jie326513988/ESP32C3-JDI-LCD-LVGL/Introducing pictures/1 (2).png

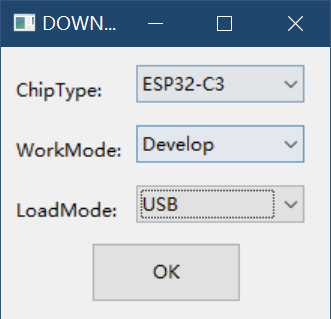
Introducing pictures/1 (2).png
