jie326513988/ESP32C3-JDI-LCD-LVGL/src/my_LVGLDemo.h

void demo_label()
{
  /*更改活动屏幕的背景色*/
  // lv_obj_set_style_bg_color(lv_screen_active(), lv_color_make(255, 0, 255), LV_PART_MAIN);

  /*Create a white label, set its text and align it to the center*/
  // lv_obj_t * label = lv_label_create(lv_screen_active());
  // lv_label_set_text(label, "Hello world");
  // lv_obj_set_style_text_color(lv_screen_active(), lv_color_hex(0xffffff), LV_PART_MAIN);
  // lv_obj_align(label, LV_ALIGN_CENTER, 0, 0);

  /*lv_obj_t *ta1 = lv_textarea_create(lv_scr_act());
  lv_obj_set_size(ta1, 70, 30);
  lv_obj_align(ta1, LV_ALIGN_CENTER, 0, -25);
  lv_obj_set_style_bg_color(ta1, lv_color_make(255, 0, 0), LV_STATE_DEFAULT);*/

  // 设置文本框的大小和位置
  /*
  lv_obj_t *ta1 = lv_textarea_create(lv_scr_act());
  lv_obj_set_size(ta1, 70, 30);
  lv_obj_align(ta1, LV_ALIGN_CENTER, 0, 30);
  lv_obj_set_style_bg_color(ta1, lv_color_make(255, 0, 0), LV_STATE_DEFAULT); // rgb
  */

  // 基本对象
  lv_obj_t *obj1 = lv_obj_create(lv_screen_active());
  lv_obj_set_scrollbar_mode(obj1, LV_SCROLLBAR_MODE_OFF);
  lv_obj_align(obj1, LV_ALIGN_TOP_MID, 0, 5);
  lv_obj_set_size(obj1, 72, 30);
  lv_obj_set_style_bg_color(obj1, MY_COLOR_GREEN, LV_STATE_DEFAULT);
  // 设置标签
  lv_obj_t *label = lv_label_create(obj1);
  lv_obj_set_scrollbar_mode(label, LV_SCROLLBAR_MODE_OFF);
  lv_label_set_long_mode(label, LV_LABEL_LONG_SCROLL_CIRCULAR);
  lv_obj_align(label, LV_ALIGN_CENTER, 0, 0);
  lv_obj_set_width(label, 72);
  //lv_label_set_text(label, "Hello Arduino, I'm LVGL! -V9.1.0");
}

void demo_img()
{
  // 1.准备一张图片
  LV_IMG_DECLARE(maomao);
  // 2.创建一个lv_img对象
  lv_obj_t *img1 = lv_image_create(lv_screen_active());
  // 3.给对象设置图片
  lv_image_set_src(img1, &maomao);
  // 4.设置图片位置
  lv_obj_align(img1, LV_ALIGN_BOTTOM_MID, 0, 0);
}

void demo_gif()
{
  /*
    // 1.准备一张图片
    LV_IMG_DECLARE(qft);
    // 2.创建一个lv_img对象
    lv_obj_t *gif1 = lv_gif_create(lv_screen_active());
    // 3.给对象设置图片
    lv_gif_set_src(gif1, &qft);
    // 4.设置图片位置
    lv_obj_align(gif1, LV_ALIGN_BOTTOM_MID, 0, 0);
  */

  // qft 千反田，tw 跳舞，xiaomai 小埋，yqs 摇汽水，liuhua 六花
  LV_IMG_DECLARE(liuhua);
  lv_obj_t *gif2 = lv_gif_create(lv_screen_active());
  lv_gif_set_src(gif2, &liuhua);
  lv_obj_align(gif2, LV_ALIGN_CENTER, 0, 0);
}

lv_point_precise_t *my_draw_rectangle(uint16_t x, uint16_t y, uint16_t w, uint16_t h)
{
  static lv_point_precise_t line_points[5]; // 静态数组，存储矩形的点
  line_points[0] = (lv_point_precise_t){x, y};
  line_points[1] = (lv_point_precise_t){x + w, y};
  line_points[2] = (lv_point_precise_t){x + w, y + h};
  line_points[3] = (lv_point_precise_t){x, y + h};
  line_points[4] = (lv_point_precise_t){x, y}; // 闭合矩形
  return line_points;
}

// 开机时进入哪个界面
void pageStartupEnters()
{
  // 更新闹钟时间差
  updatealarmClockDifference(1);

  // 0点唤醒的 并且 不是时钟界面
  if (RTC_ac_wp > 0 && RTC_disPage_old != page_clock)
  {
    // 5秒内视为有闹钟
    if (abs(AC_timeTarget) <= 5)
    {
      AC_timeTarget = AC_WAKE_UP; // 标记唤醒时有闹钟
    }
    else esp_sleep(0);
  }

  // 开机长按确认键10秒进入按键校准界面
  int16_t count = 0;
  while (analogRead(KEY_ADC_PIN) <= 100)
  {
    delay(10);
    count++;
    if (count > 100)
    {
      eep_keyADCUp = 5000;
      eep_keyADCUp = 5000;
      break;
    }
  }

  bool anim = 1; // 是否启用动画
  //Serial.printf("eep_keyADCUp:%d\n",eep_keyADCUp);
  //Serial.printf("eep_keyADCDown:%d\n",eep_keyADCDown);
  if (eep_keyADCUp >= 5000 || eep_keyADCDown >= 5000)
  {
    display_keyADC_cali_init();
    buzzer_active();
  }
  else if (eep_disPage == page_clock)
  {
    // 检查闹钟 5秒内视为有闹钟
    if (abs(AC_timeTarget) <= 5)
    {
      RTC_timedWakeUp = 0;
      AC_timeTarget = AC_WAKE_UP; // 标记唤醒时有闹钟
    }

    display_clock_init();

    // 是定时唤醒的标记不需要动画
    if (RTC_timedWakeUp == 1)  
    {
      anim = 0;
      //添加屏幕保护刷屏 单位分钟
      RTC_clock_count++;
      if (RTC_clock_count > 120)
      {
        RTC_clock_count = 0;
        display_screenSaver_init();
        lv_screen_load_anim(page.p[page.index], LV_SCR_LOAD_ANIM_OVER_LEFT, 100, 0, true);
        return;
      }
    }
    // 不是定时唤醒 打开定时读取时间
    else bitWrite(backgroundTask, BGT_CLOCK_READ, 1);
  }
  else if (eep_disPage == page_acc)
  {
    display_acc_init();
    bitWrite(backgroundTask, BGT_ACC_READ, 1); // 标记打开任务
  }
  else if (eep_disPage == page_mainSet)
  {
    display_mainSet_init();
  }
  else if (eep_disPage == page_air)
  {
    display_air_init();
    bitWrite(backgroundTask, BGT_AIR_READ, 1); // 标记打开任务
  }
  else if (eep_disPage == page_alarmClock)
  {
    display_alarmClock_init();
  }
  else if (eep_disPage == page_fileExplorer)
  {
    fileManagerInit(1);
    display_fileExplorer_init();
  }
  else if (eep_disPage == page_memoSet)
  {
    display_memoSet_init();
  }
  else if (eep_disPage == page_memo)
  {
    display_memo_init();
  }
  else//防止错误
  {
    display_jitterSet_init();
  }

  //Serial.printf("eep_disPage:%d\n", eep_disPage);
  if (anim) //需要动画
  {
    lv_screen_load_anim(page.p[page.index], LV_SCR_LOAD_ANIM_FADE_IN, 1000, 0, false);
    onGlobalJitter(1000); // 打开全局抖动
  }
  else // 不需要动画
  {
    lv_screen_load(page.p[page.index]);
  }
}

//********** 在事件内添加动画，动画不会重叠 返回1动画播放中 返回0动画启动
bool addAnimation_event(lv_obj_t *obj1, void (*animFunctions)(lv_obj_t *obj2), lv_anim_exec_xcb_t exec_cb)
{
  lv_anim_t *a = lv_anim_get(obj1, exec_cb); //button_width_shrink_anim_cb
  if (a != NULL) return 1; // 如果动画正在播放，直接返回
  animFunctions(obj1);     // 调用动画函数
  return 0;
}

//****** 自写弹窗 带动画
/*
lv_anim_path_linear 线性动画
lv_anim_path_step 最后一步改变
lv_anim_path_ease_in 开始时很慢
lv_anim_path_ease_out 最后慢
lv_anim_path_ease_in_out 开始和结束都很慢
lv_anim_path_overshoot 超过结束值
lv_anim_path_bounce 从最终值反弹一点（比如撞墙）
*/
// 弹窗动画 对X轴变化
void my_msgbox_anim_x_cb(void *var, int32_t v) 
{
  //lv_obj_set_x((lv_obj_t *)var, v);
  lv_obj_align((lv_obj_t *)var, LV_ALIGN_LEFT_MID, v, 0);
  //Serial.printf("v:%d\n",v);
}
// 弹窗退出动画结束时删除自己
void my_msgbox_exit_anim_end_cd(lv_anim_t *a) 
{
  // lv_obj_delete((lv_obj_t *)a->var);
  lv_obj_delete(mbox.p); // 删除对象
  mbox.p = NULL;         // 对象地址清空
  mbox.keyMode = KEY_MODE_RL;

  if (group_old != NULL)
  {
    lv_indev_set_group(indev, group_old); // 将组邦定到按键 group_my
    lv_obj_t *obj = lv_group_get_focused(group_old);
    group_old = NULL;
    if (obj != NULL)
      lv_obj_set_state(obj, LV_STATE_PRESSED, false); // 设置状态
  }

  // 检查清空标志
  /*if (bitRead(mbox.state, MBOX_STATE_CLEAR) == 1)
  {
    mbox.title.clear();
    mbox.text.clear();
    mbox.time = 0;
    mbox.recordTime = 0;
    mbox.button.clear();
    mbox.event_cb = NULL;
    bitWrite(mbox.state, MBOX_STATE_CLEAR, 0);
  }*/

  // 定时器存在，删除定时器
  if (lvTimer_msgbox)
  {
    lv_timer_delete(lvTimer_msgbox);
    lvTimer_msgbox = NULL;
  }

  bitWrite(mbox.state, MBOX_STATE_EXIT, 0);   // 标记退出完毕
  bitWrite(mbox.state, MBOX_STATE_REMAIN, 0); // 标记停留阶段结束
  bitWrite(mbox.state, MBOX_STATE_TIMER, 0);  // 取消标记定时器运行阶段
  bitWrite(mbox.state, MBOX_STATE_ENTER, 0);  // 标记进入阶段结束
  /*Serial.println("弹窗退出完毕");
  Serial.print("mbox.state:");
  Serial.println(mbox.state, BIN);
  Serial.println();*/
}
// 弹窗退出 设置多少秒后退出的定时器回调
void my_msgbox_setExit_timer_cb(lv_timer_t *e)
{
  bitWrite(mbox.state, MBOX_STATE_EXIT, 1); // 标记退出中
  int16_t x = lv_obj_get_x(mbox.p);
  lv_anim_t b;
  lv_anim_init(&b);                                         // 动画初始化
  lv_anim_set_var(&b, mbox.p);                              // 设置需要动画的对象
  lv_anim_set_values(&b, x, -78);                           // 设置动画的开始值和结束值
  lv_anim_set_duration(&b, MSGBOX_ANIM_TIME);               // 设置动画的持续时间
  lv_anim_set_exec_cb(&b, my_msgbox_anim_x_cb);             // 设置需要变化的值
  lv_anim_set_path_cb(&b, lv_anim_path_ease_in);            // 设置变化特效
  lv_anim_set_completed_cb(&b, my_msgbox_exit_anim_end_cd); // 设置动画完成时的函数调用
  lv_anim_start(&b);                                        // 动画开始
  //Serial.println("弹窗退出动画开始");
}
// 弹窗退出 供用户调用
void my_msgbox_exit(uint32_t delay_ms)
{
  if (mbox.p == NULL)
  {
    //Serial.println("无弹窗返回");
    return;
  }
  if (bitRead(mbox.state, MBOX_STATE_EXIT))
  {
    //Serial.println("弹窗退出中返回");
    return;
  }

  //Serial.println("弹窗退出开始创建");

  if (lvTimer_msgbox)
  {
    lv_timer_pause(lvTimer_msgbox);  // 暂停
    lv_timer_delete(lvTimer_msgbox); // 删除
    lvTimer_msgbox = NULL;
  }

  if (delay_ms < 5) // 小于5ms直接运行
  {
    my_msgbox_setExit_timer_cb(NULL);
    return;
  } 

  bitWrite(mbox.state, MBOX_STATE_TIMER, 1); // 标记定时器运行阶段
  // 创建一个单次定时器
  lvTimer_msgbox = lv_timer_create(my_msgbox_setExit_timer_cb, delay_ms, NULL);
  lv_timer_set_repeat_count(lvTimer_msgbox, 1);
  lv_timer_set_auto_delete(lvTimer_msgbox, false);
}
// 弹窗进入动画结束回调
void my_msgbox_enter_anim_end_cd(lv_anim_t *a)
{
  //Serial.println("弹窗进入动画结束");
  bitWrite(mbox.state, MBOX_STATE_ENTER, 0);  // 标记进入阶段结束
  bitWrite(mbox.state, MBOX_STATE_REMAIN, 1); // 标记进入停留阶段
}
// 强制发送弹窗 供用户调用
void my_msgbox_forceSend(String title_in, String text_in, uint16_t time, String button, lv_event_cb_t event_cb)
{
  bitWrite(mbox.state, MBOX_STATE_FORCE, 1); // 标记强制发送
  my_msgbox_send(title_in, text_in, time, button, event_cb);
}
// 正常发送弹窗 供用户调用
void my_msgbox_send(String title_in, String text_in, uint16_t time, String button, lv_event_cb_t event_cb)
{
  //Serial.println("弹窗发送");
  //Serial.printf("title_in:%s\n", title_in.c_str());
  //Serial.printf("text_in:%s\n", text_in.c_str());
  //Serial.printf("time:%d\n", time);
  bitWrite(mbox.state, MBOX_STATE_SEND, 1); // 标记发送阶段
  if(title_in) mbox.title = title_in;
  if(text_in)  mbox.text = text_in;
  mbox.time = time;
  if(button)   mbox.button = button;
  if(event_cb) mbox.event_cb = event_cb;
}
// 弹窗进入，供my_msgbox_loop调用，用户勿调用
void my_msgbox(String title_in, String text_in, uint16_t time, String button, lv_event_cb_t event_cb) 
{
  //uint8_t index = msgboxInit();
  bitWrite(mbox.state, MBOX_STATE_ENTER, 1); // 标记进入阶段
  bitWrite(mbox.state, MBOX_STATE_SEND, 0); // 标记发送结束

  // 进入前先清空
  mbox.title.clear();
  mbox.text.clear();
  mbox.time = 0;
  mbox.button.clear();
  mbox.event_cb = NULL;

  const char *title = title_in.c_str();
  const char *text = text_in.c_str();
  // 计算按钮的数量
  uint8_t butNum = 0;
  String button_name[3];
  for (uint8_t i = 0; i < button.length(); i++)
  {
    if (button[i] != '\n') button_name[butNum] += button[i];
    else                   butNum++;
    if (butNum >= 3) break;
  }

  // 大框
  mbox.p = lv_obj_create(lv_layer_top());
  lv_obj_set_scrollbar_mode(mbox.p, LV_SCROLLBAR_MODE_OFF); //关闭滑动条
  //uint16_t width_title = lv_text_get_width(title, strlen(title), lv_obj_get_style_text_font(mbox.p, 0), 0);
  //uint16_t width_text = lv_text_get_width(text, strlen(text), lv_obj_get_style_text_font(mbox.p, 0), 0);
  //uint16_t width_title_zl = (width_title / 69);
  //uint16_t width_text_zl = (width_text / 69);
  //Serial.printf("width_text:%d\n", width_text);
  //Serial.printf("width_text_zl:%d\n", width_text_zl);
  //lv_obj_set_size(mbox.p, 78, 48 + ((width_title_zl + width_text_zl) * 20));
  lv_obj_set_size(mbox.p, 78, 144);
  lv_obj_align(mbox.p, LV_ALIGN_LEFT_MID, -78, 0);
  lv_obj_set_style_text_color(mbox.p, MY_COLOR_BLACK, LV_STATE_DEFAULT);   // 字体颜色
  lv_obj_set_style_border_color(mbox.p, MY_COLOR_BLACK, LV_STATE_DEFAULT); // 边框颜色
  lv_obj_set_style_border_width(mbox.p, 2, LV_STATE_DEFAULT);              // 边框宽度
  lv_obj_set_style_pad_all(mbox.p, 0, LV_STATE_DEFAULT);                   // 边距
  lv_obj_set_style_radius(mbox.p, 9, LV_STATE_DEFAULT);                    // 设置圆角
  lv_obj_set_style_bg_opa(mbox.p, LV_OPA_100, LV_STATE_DEFAULT);

  lv_obj_update_layout(mbox.p); // 更新布局
  uint16_t i_w = lv_obj_get_width(mbox.p);
  uint16_t i_h = lv_obj_get_height(mbox.p);
  uint16_t i_r = lv_obj_get_style_radius(mbox.p, LV_STATE_DEFAULT);

  // 内边框
  lv_obj_t *innerBorder = lv_obj_create(mbox.p);
  lv_obj_set_style_bg_opa(innerBorder, LV_OPA_0, LV_STATE_DEFAULT);
  lv_obj_set_style_border_color(innerBorder, MY_COLOR_CYAN, LV_STATE_DEFAULT);
  lv_obj_set_style_border_width(innerBorder, 2, LV_STATE_DEFAULT);
  lv_obj_set_style_pad_all(innerBorder, 0, LV_STATE_DEFAULT);
  lv_obj_set_style_radius(innerBorder, i_r - 2, LV_STATE_DEFAULT);
  lv_obj_set_size(innerBorder, i_w - 4, i_h - 4);
  lv_obj_align(innerBorder, LV_ALIGN_CENTER, 0, 0);

  // 标题
  lv_obj_t *box_title = lv_label_create(mbox.p);
  // lv_obj_set_style_border_width(box_title, 0, LV_STATE_DEFAULT); // 边框宽度
  // lv_obj_set_style_pad_all(box_title, 0, LV_STATE_DEFAULT);      // 边距
  lv_obj_set_width(box_title, 66);                                                // 设置宽度
  lv_obj_align(box_title, LV_ALIGN_TOP_MID, 1, 2);                                // 设置对齐方式
  lv_obj_set_style_text_color(box_title, MY_COLOR_WHITE, LV_STATE_DEFAULT);       // 设置文本颜色
  lv_label_set_long_mode(box_title, LV_LABEL_LONG_WRAP);                          // 设置文本长字符模式
  lv_obj_set_style_text_align(box_title, LV_TEXT_ALIGN_CENTER, LV_STATE_DEFAULT); // 设置文本对齐方式
  lv_label_set_text(box_title, title);                                            // 打印文本
  
  // 标题的背景
  lv_obj_t *title_bg = lv_obj_create(mbox.p);
  lv_obj_set_style_border_width(title_bg, 0, LV_STATE_DEFAULT);
  lv_obj_set_style_bg_color(title_bg, MY_COLOR_BLACK, LV_STATE_DEFAULT);
  lv_obj_set_style_pad_all(title_bg, 0, LV_STATE_DEFAULT); // 边距
  lv_obj_set_style_radius(title_bg, 0, LV_STATE_DEFAULT);  // 设置圆角
  lv_obj_update_layout(mbox.p);// 更新布局
  lv_obj_set_size(title_bg, i_w - 8, lv_obj_get_height(box_title));
  lv_obj_align(title_bg, LV_ALIGN_TOP_MID, 0, 2);
  lv_obj_swap(title_bg, box_title); // 交换层级

  // 内容
  lv_obj_t *box_text = lv_label_create(mbox.p);
  lv_obj_set_width(box_text, 66);                                                // 设置宽度
  lv_obj_align_to(box_text, box_title, LV_ALIGN_OUT_BOTTOM_MID, 0, 1);           // 设置对齐方式
  lv_label_set_long_mode(box_text, LV_LABEL_LONG_WRAP);                          // 设置文本长字符模式
  lv_obj_set_style_text_align(box_text, LV_TEXT_ALIGN_CENTER, LV_STATE_DEFAULT); // 设置文本对齐方式
  lv_label_set_text(box_text, text);                                             // 打印文本

  // 更新大框的尺寸
  uint8_t additional = 14; //额外高度
  if (butNum == 0) additional = 8; //没有按钮时只需要8
  lv_obj_update_layout(mbox.p); // 更新布局
  i_h = lv_obj_get_height(box_title) + lv_obj_get_height(box_text) + additional + (butNum * 23);
  lv_obj_set_size(mbox.p, 78, i_h);
  lv_obj_align(mbox.p, LV_ALIGN_LEFT_MID, -7, 0);
  // 更新内框的尺寸
  lv_obj_set_size(innerBorder, i_w - 4, i_h - 4);
  lv_obj_align(innerBorder, LV_ALIGN_CENTER, 0, 0);
  lv_obj_move_to_index(innerBorder, lv_obj_get_index(mbox.p) - 2); // 移动到顶层-1

  // Serial.printf("box_title_higth:%d\n", lv_obj_get_height(box_title));
  // Serial.printf("box_text_higth:%d\n", lv_obj_get_height(box_text));
  // Serial.printf("i_h:%d\n", i_h);

  // 按钮存在
  if (butNum != 0)
  {
    // 记录现在的组，以便在退出时恢复
    group_old = lv_indev_get_group(indev);
    // 启用弹窗组
    lv_indev_set_group(indev, group_mbox0);
    // 使能 lv_layer_top 点击
    // lv_obj_add_flag(lv_layer_top(), LV_OBJ_FLAG_CLICKABLE);
    // lv_obj_add_flag(lv_layer_top(), LV_OBJ_FLAG_SCROLL_WITH_ARROW);
    mbox.keyMode = KEY_MODE_PN; // 切换至焦点模式

    // 设置文本的背景
    lv_obj_t *text_bg = lv_obj_create(mbox.p);
    lv_obj_set_style_bg_color(text_bg, MY_COLOR_YELLOW, LV_STATE_DEFAULT);
    lv_obj_set_style_border_width(text_bg, 0, LV_STATE_DEFAULT); // 边框宽度
    lv_obj_set_style_pad_all(text_bg, 0, LV_STATE_DEFAULT);      // 边距
    lv_obj_set_style_radius(text_bg, 0, LV_STATE_DEFAULT);       // 设置圆角
    lv_obj_update_layout(mbox.p); // 更新布局
    lv_obj_set_size(text_bg, i_w - 8, lv_obj_get_height(box_text));
    lv_obj_align_to(text_bg, title_bg, LV_ALIGN_OUT_BOTTOM_MID, 0, 0);
    lv_obj_swap(text_bg, box_text); //交换层级

    // 绘制按钮
    lv_obj_t *but[butNum];
    lv_obj_t *label[butNum];
    lv_color_t color[3] = {MY_COLOR_RED, MY_COLOR_GREEN, MY_COLOR_CYAN};
    for (uint8_t i = 0; i < butNum; i++)
    {
      // 创建按钮
      but[i] = lv_button_create(mbox.p);
      lv_obj_set_size(but[i], 65, 19);
      if (i == 0)
        lv_obj_align_to(but[i], box_text, LV_ALIGN_OUT_BOTTOM_MID, -4, 5);
      else
        lv_obj_align_to(but[i], but[i - 1], LV_ALIGN_OUT_BOTTOM_MID, 0, 4);
      lv_obj_set_style_radius(but[i], 4, LV_STATE_DEFAULT);                       // 设置圆角
      lv_obj_add_style(but[i], &style_shadow, LV_STATE_DEFAULT);                  // 添加不透明度样式
      lv_obj_set_style_bg_color(but[i], color[i], LV_STATE_DEFAULT);              // 设置背景颜色
      lv_obj_set_style_outline_width(but[i], 2, LV_STATE_FOCUS_KEY);              // 聚焦框的宽度
      lv_obj_set_style_outline_pad(but[i], 0, LV_STATE_FOCUS_KEY);                // 聚焦框的间隙
      lv_obj_set_style_outline_opa(but[i], LV_OPA_100, LV_STATE_FOCUS_KEY);       // 聚焦框的不透明度
      lv_obj_set_style_outline_width(but[i], 0, LV_STATE_DEFAULT);                // 失焦时的宽度
      lv_obj_set_style_outline_color(but[i], MY_COLOR_BLACK, LV_STATE_FOCUS_KEY); // 聚焦框颜色

      // 创建标签
      label[i] = lv_label_create(but[i]);
      lv_obj_align(label[i], LV_ALIGN_CENTER, 0, 1);            // 设置对齐方式
      if (i == 0)
        lv_obj_set_style_text_color(label[i], MY_COLOR_WHITE, 0); // 设置字体颜色
      else
        lv_obj_set_style_text_color(label[i], MY_COLOR_BLACK, 0); // 设置字体颜色
      lv_label_set_text(label[i], button_name[i].c_str());         // 打印文本

      // 将按键邦定到组
      lv_group_add_obj(group_mbox0, but[i]);
      // 添加按钮聚焦动画
      lv_obj_add_event_cb(but[i], buttonFocus_anim_event, LV_EVENT_FOCUSED, NULL);
      // 添加按钮按下回调
      lv_obj_add_event_cb(but[i], event_cb, LV_EVENT_PRESSED, &num[i]);
    }

    // 创建线条
    static lv_point_precise_t line_points[] = {{0, 0}, {69, 0}};
    lv_obj_t * line1;
    line1 = lv_line_create(mbox.p);
    lv_line_set_points(line1, line_points, 2); 
    lv_obj_set_style_line_width(line1, 2, 0);
    lv_obj_set_style_line_color(line1,MY_COLOR_CYAN,0);
    //lv_obj_set_style_outline_opa(line1, LV_OPA_0, 0);
    //lv_obj_add_style(line1, &style_shadow, LV_STATE_DEFAULT); // 添加不透明度样式
    //lv_obj_set_style_line_rounded(line1, true, 0);
    lv_obj_align_to(line1, text_bg, LV_ALIGN_OUT_BOTTOM_MID, 0, 1);
    //lv_obj_center(line1);
  }

  // lv_obj_set_style_border_color(box_title, MY_COLOR_BLACK, LV_STATE_DEFAULT);
  // lv_obj_set_style_border_width(box_title, 1, LV_STATE_DEFAULT);
  // lv_obj_set_style_bg_color(box_title, MY_COLOR_BLACK, LV_STATE_DEFAULT);
  // lv_obj_set_style_bg_color(box_content, lv_color_make(255, 255, 0), LV_STATE_DEFAULT);
  // lv_obj_set_style_bg_opa(box_title, LV_OPA_100, LV_STATE_DEFAULT);
  // lv_obj_set_style_bg_opa(box_content, LV_OPA_100, LV_STATE_DEFAULT);

  // 给弹窗添加进入动画
  //Serial.println("弹窗创建");
  //Serial.printf("title_in:%s\n",title_in.c_str());
  //Serial.printf("text_in:%s\n",text_in.c_str());
  //Serial.printf("time:%d\n",time);
  //int16_t x = lv_obj_get_x(mbox.p);
  //Serial.printf("x:%d\n",x);

  lv_anim_t a;
  lv_anim_init(&a);                                          // 动画初始化
  lv_anim_set_var(&a, mbox.p);                               // 设置需要动画的对象
  lv_anim_set_values(&a, -78, -7);                           // 设置动画的开始值和结束值
  lv_anim_set_duration(&a, MSGBOX_ANIM_TIME);                // 设置动画的持续时间
  lv_anim_set_exec_cb(&a, my_msgbox_anim_x_cb);              // 设置需要变化的值
  lv_anim_set_path_cb(&a, lv_anim_path_bounce);              // 设置变化特效
  lv_anim_set_completed_cb(&a, my_msgbox_enter_anim_end_cd); // 设置动画完成时的函数调用
  lv_anim_start(&a);     // 动画开始
                                      
  if (time > 0) //一段时间后退出
  {
    //lv_obj_delete_delayed(mbox.p, time);
    my_msgbox_exit(MSGBOX_ANIM_TIME + time);
  }
}
// 弹窗监测 放到loop任务中使用，用户勿调用
void my_msgbox_loop()
{
  if(mbox.state == 0)  return; 

  // 强制发送时
  if (bitRead(mbox.state, MBOX_STATE_FORCE) == 1) 
  {
    // Serial.println("强制发送");
    mbox.state = 0;     // 状态清零重新开始
    if (mbox.p != NULL) // 删除现在的弹窗
    {
      lv_obj_delete(mbox.p); // 删除对象
      mbox.p = NULL;         // 对象地址清空
      // 定时器存在，删除定时器
      if (lvTimer_msgbox)
      {
        lv_timer_delete(lvTimer_msgbox);
        lvTimer_msgbox = NULL;
      }
    }
    bitWrite(mbox.state, MBOX_STATE_SEND, 1); // 标记发送阶段
    my_msgbox(mbox.title, mbox.text, mbox.time, mbox.button, mbox.event_cb);
    return;
  }

  if(bitRead(mbox.state, MBOX_STATE_ENTER) == 1) return;  // 进入阶段 返回
  if(bitRead(mbox.state, MBOX_STATE_EXIT) == 1)  return;  // 退出阶段 返回
  //if(bitRead(mbox.state, MBOX_STATE_TIMER) == 1)  return; // 定时阶段 返回

  // 有新的弹窗进入，挤掉现在的弹窗
  if (mbox.p != NULL && bitRead(mbox.state, MBOX_STATE_SEND) == 1)
  {
    //Serial.println("新的弹窗挤入1");
    if (millis() - mbox.recordTime < 800) return; // 最少运行800毫秒
    //Serial.println("新的弹窗挤入2");
    //bitWrite(mbox.state, MBOX_STATE_CLEAR, 0); // 标记不清空
    my_msgbox_exit(0);                         // 退出当前弹窗
    return;
  }

  if(bitRead(mbox.state, MBOX_STATE_REMAIN) == 1) return;

  //bitWrite(mbox.state, MBOX_STATE_CLEAR, 1); // 标记下次退出需要清空内容和标志位
  mbox.recordTime = millis();                // 记录整体运行时间，包括动画运行时间
  my_msgbox(mbox.title, mbox.text, mbox.time, mbox.button, mbox.event_cb);
}

//关闭LVGL的定时器和rtos任务
void offLVGLTimer()
{
  if (lvTimer_share[0] != NULL)
  {
    lv_timer_delete(lvTimer_share[0]);
    lvTimer_share[0] = NULL;
    //Serial.println("关闭LVGL的定时器");
    //*** 码表和定位信息界面
    if (eep_disPage == page_stopwatch || eep_disPage == page_locateInfo)
      bitWrite(backgroundTask, BGT_LOCATE_INFO_READ, 0); // 关闭卫星读取任务
    //*** 前置光设置界面
    else if (eep_disPage == page_frontLightSet)
      bitWrite(backgroundTask, BGT_AMBIENT_LIGHT, 0); // 关闭环境光读取任务
  }
}
// 通用 退出至设置菜单
void exitToMainSet()
{
  display_mainSet_init();

  //Serial.print("get_focusPos_old[" + String(focusPos_old_index) + "]:");
  //Serial.println(focusPos_old[focusPos_old_index]);

  // 决定怎么滚动对齐
  if (focusPos_old[focusPos_old_index] >= 2) 
    lv_obj_set_scroll_snap_y(page.p[page.index], LV_SCROLL_SNAP_CENTER); // 对齐中心
  else
    lv_obj_set_scroll_snap_y(page.p[page.index], LV_SCROLL_SNAP_NONE); // 不要对齐，留在原地

  lv_screen_load_anim(page.p[page.index], LV_SCR_LOAD_ANIM_FADE_OUT, GRADUAL_ANIM_TIME, 100, true);
  onGlobalJitter();     // 打开全局抖动
  focusPosOld_return(); // 回到刚才的焦点
}
// 通用 弹窗的退出返回，返回则返回至主设置页面
void backPage_mainSet(lv_event_t *e) 
{
  uint8_t *data = (uint8_t *)lv_event_get_user_data(e);
  if (data[0] == 0) // 退出
  {
    offLVGLTimer();     // 关闭LVGL定时器
    my_msgbox_exit(10); // 退出弹窗
    exitToMainSet();    // 退出至设置菜单
  }
  else if (data[0] == 1) // 返回
  {
   my_msgbox_exit(10); // 退出弹窗
  }
}
// 通用 退出至设置菜单的回调
void backPage_mainSet_event(lv_event_t *e)
{
  offLVGLTimer();  // 关闭LVGL定时器
  exitToMainSet(); // 退出至设置菜单
}
void msgbox_exit_cb(lv_event_t *e) // 通用 弹窗退出回调
{
  buzzerSen(30);
  my_msgbox_exit(5); // 退出弹窗
}
//key-按键模式： 0左右切换 1焦点切换
//first： 是否有在回调里只执行一次的命令
uint8_t pageInit(bool key, bool first)
{
  page.keyMode = key;
  page.firstEvent = first;
  page.index++;
  if(page.index > 1) page.index = 0;
  return page.index;
}

//****** 动画相关
void button_width_shrink_anim_init(lv_obj_t *obj) // 按键横向向内收缩初始化
{
  buzzerSen(30);
  uint8_t w = lv_obj_get_width(obj);
  // Serial.printf("w:%d\n", w);
  lv_anim_t a;
  lv_anim_init(&a);                                              // 动画初始化
  lv_anim_set_var(&a, obj);                                      // 设置需要动画的对象
  lv_anim_set_values(&a, w, w - 10);                             // 设置动画的开始值和结束值
  lv_anim_set_duration(&a, BUTTON_ANIM_TIME);                    // 设置动画的持续时间
  lv_anim_set_exec_cb(&a, button_width_shrink_anim_cb);          // 设置需要变化的值
  lv_anim_set_path_cb(&a, lv_anim_path_bounce);                  // 设置变化特效
  lv_anim_set_completed_cb(&a, button_width_shrink_anim_end_cb); // 设置动画完成时的函数调用
  // lv_anim_set_user_data(&a, user_data);                          // 添加当前的用户数据
  lv_anim_start(&a);
}
void button_width_shrink_anim_cb(void *var, int32_t v) // 按钮横向收缩变化
{
  lv_obj_set_width((lv_obj_t *)var, v);
}
void markAnimIdle(lv_anim_t *a) // 标记按钮动画空闲
{
  bool *state = (bool *)lv_anim_get_user_data(a);
  if (state != NULL)
  {
    //Serial.printf("state2:%p\n", state);   // 输出地址
    //Serial.printf("*state2:%d\n", *state); // 输出值
    //Serial.print("animState[" + String(animStateIndex) + "]2:");
    //Serial.println(animState[animStateIndex]);
    *state = 0;
  }
}
void button_width_shrink_anim_end_cb(lv_anim_t *a) // 按钮横向收缩动画结束回调
{
  uint8_t w = lv_obj_get_width((lv_obj_t *)a->var);
  // Serial.printf("h2:%d\n",h);
  lv_anim_t b;
  lv_anim_init(&b);                                     // 动画初始化
  lv_anim_set_var(&b, a->var);                          // 设置需要动画的对象
  lv_anim_set_values(&b, w, w + 10);                    // 设置动画的开始值和结束值
  lv_anim_set_duration(&b, BUTTON_ANIM_TIME);           // 设置动画的持续时间
  lv_anim_set_exec_cb(&b, button_width_shrink_anim_cb); // 设置需要变化的值
  lv_anim_set_path_cb(&b, lv_anim_path_bounce);         // 设置变化特效
  //lv_anim_set_completed_cb(&b, markAnimIdle); // 设置动画完成时的函数调用
  //lv_anim_set_user_data(&b, lv_anim_get_user_data(a));
  lv_anim_start(&b);
}
void button_height_expand_anim_cb(void *var, int32_t v) // 按钮高度扩展变化
{
  lv_obj_set_height((lv_obj_t *)var, v);
  lv_obj_scroll_to_view((lv_obj_t *)var, LV_ANIM_ON);
}
void buttonFocus_anim_event(lv_event_t *e) // 按钮聚焦播放外框缩放动画
{
  //Serial.println("按钮聚焦");
  lv_obj_t *obj = lv_event_get_target_obj(e);
  bool run = addAnimation_event(obj, button_width_shrink_anim_init, button_width_shrink_anim_cb); // 添加动画不重叠
  if (run == 1) return;
  //button_width_shrink_anim_init(obj);
  LV_UNUSED(obj);
}

void button_editNumEject_anim_cb(void *var, int32_t v) // 标签从下弹出动画变化
{
  lv_obj_align((lv_obj_t *)var, LV_ALIGN_BOTTOM_MID, 0, v); // 对齐方式
}

void label_y_bounce_anim_cb(void *var, int32_t v)         // Y轴弹跳动画变化回调
{
  lv_obj_set_y((lv_obj_t *)var, v);
  //Serial.printf("y1:%d\n", v);
}
void label_y_bounce_anim_init(lv_obj_t *obj, int16_t val) // Y轴弹跳动画
{
  int16_t y = lv_obj_get_y(obj);
  //Serial.printf("y0:%d\n", y);
  lv_anim_t a;
  lv_anim_init(&a);                                // 动画初始化
  lv_anim_set_var(&a, obj);                        // 设置需要动画的对象
  lv_anim_set_values(&a, y + val, y);              // 设置动画的开始值和结束值
  lv_anim_set_duration(&a, BUTTON_ANIM_TIME);      // 设置动画的持续时间
  lv_anim_set_exec_cb(&a, label_y_bounce_anim_cb); // 设置需要变化的值
  lv_anim_set_path_cb(&a, lv_anim_path_ease_out);  // 设置变化特效
  // lv_anim_set_completed_cb(&a, label_y_up_anim_end_cb); // 设置动画完成时的函数调用
  lv_anim_start(&a);
}
void label_x_bounce_anim_cb(void *var, int32_t v)         // X轴弹跳动画变化回调
{
  lv_obj_set_x((lv_obj_t *)var, v);
  //Serial.printf("x1:%d\n", v);
}
void label_x_bounce_anim_init(lv_obj_t *obj, int16_t val) // X轴弹跳动画
{
  int16_t x = lv_obj_get_x(obj);
  //Serial.printf("x0:%d\n", x);
  //Serial.printf("val:%d\n", val);
  lv_anim_t a;
  lv_anim_init(&a);                                // 动画初始化
  lv_anim_set_var(&a, obj);                        // 设置需要动画的对象
  lv_anim_set_values(&a, x + val, x);              // 设置动画的开始值和结束值
  lv_anim_set_duration(&a, BUTTON_ANIM_TIME);      // 设置动画的持续时间
  lv_anim_set_exec_cb(&a, label_x_bounce_anim_cb); // 设置需要变化的值
  lv_anim_set_path_cb(&a, lv_anim_path_ease_out);  // 设置变化特效
  // lv_anim_set_completed_cb(&a, label_y_up_anim_end_cb); // 设置动画完成时的函数调用
  lv_anim_start(&a);
}
void buttonFocus_anim_event1(lv_event_t *e)  // 按钮聚焦播放文字随机跳动动画 lv_obj_get_x/y
{
  //Serial.println("按钮聚焦1");
  lv_obj_t *obj = lv_event_get_target_obj(e);  // 按钮对象
  lv_obj_t *child0 = lv_obj_get_child(obj, 0); // 第0个子代，按钮的即文本标签

  lv_anim_t *a = lv_anim_get(child0, label_y_bounce_anim_cb);
  if (a != NULL) return; // 如果动画正在播放，直接返回
  //Serial.printf("y:%d\n",lv_obj_get_y(child0));
  label_y_bounce_anim_init(child0, random(-5, 5));

  lv_anim_t *b = lv_anim_get(child0, label_x_bounce_anim_cb);
  if (b != NULL) return; // 如果动画正在播放，直接返回
  //Serial.printf("x:%d\n",lv_obj_get_x(child0));
  label_x_bounce_anim_init(child0, random(-10, 10));
}

void label_y_bounce_anim_cb1(void *var, int32_t v)         // Y轴弹跳动画变化回调
{
  //lv_align_t s = lv_obj_get_style_align((lv_obj_t *)var, 0);
  //lv_obj_align((lv_obj_t *)var, s, 0, v);
  lv_obj_set_y((lv_obj_t *)var, v);
  //Serial.printf("y1:%d\n", v);
}
void label_y_bounce_anim_init1(lv_obj_t *obj, int16_t val) // Y轴弹跳动画
{
  int16_t y = lv_obj_get_y_aligned(obj);
  //Serial.printf("y0:%d\n", y);
  lv_anim_t a;
  lv_anim_init(&a);                                // 动画初始化
  lv_anim_set_var(&a, obj);                        // 设置需要动画的对象
  lv_anim_set_values(&a, y + val, y);              // 设置动画的开始值和结束值
  lv_anim_set_duration(&a, LABEL_ANIM_TIME);      // 设置动画的持续时间
  lv_anim_set_exec_cb(&a, label_y_bounce_anim_cb1); // 设置需要变化的值
  lv_anim_set_path_cb(&a, lv_anim_path_ease_out);  // 设置变化特效
  // lv_anim_set_completed_cb(&a, label_y_up_anim_end_cb); // 设置动画完成时的函数调用
  lv_anim_start(&a);
}
void label_x_bounce_anim_cb1(void *var, int32_t v)         // X轴弹跳动画变化回调
{
  //lv_align_t s = lv_obj_get_style_align((lv_obj_t *)var, 0);
  //lv_obj_set_align((lv_obj_t *)var, s);
  lv_obj_set_x((lv_obj_t *)var, v);
  //lv_obj_align((lv_obj_t *)var, s, v, 0);
  //Serial.printf("x1:%d\n", v);
}
void label_x_bounce_anim_init1(lv_obj_t *obj, int16_t val) // X轴弹跳动画
{
  int16_t x = lv_obj_get_x_aligned(obj);

  //Serial.printf("x0:%d\n", x); lv_obj_get_x
  //Serial.printf("val:%d\n", val);
  lv_anim_t a;
  lv_anim_init(&a);                                // 动画初始化
  lv_anim_set_var(&a, obj);                        // 设置需要动画的对象
  lv_anim_set_values(&a, x + val, x);              // 设置动画的开始值和结束值
  lv_anim_set_duration(&a, LABEL_ANIM_TIME);      // 设置动画的持续时间
  lv_anim_set_exec_cb(&a, label_x_bounce_anim_cb1); // 设置需要变化的值
  lv_anim_set_path_cb(&a, lv_anim_path_ease_out);  // 设置变化特效
  // lv_anim_set_completed_cb(&a, label_y_up_anim_end_cb); // 设置动画完成时的函数调用
  lv_anim_start(&a);
}
void buttonFocus_anim_event2(lv_event_t *e)  // 按钮聚焦播放文字随机跳动动画 lv_obj_get_x_aligned
{
  //Serial.println("按钮聚焦2");
  lv_obj_t *obj = lv_event_get_target_obj(e);  // 按钮对象
  lv_obj_t *child0 = lv_obj_get_child(obj, 0); // 第0个子代，按钮的即文本标签

  lv_anim_t *a = lv_anim_get(child0, label_y_bounce_anim_cb1);
  if (a != NULL) return; // 如果动画正在播放，直接返回
  //Serial.printf("y:%d\n",lv_obj_get_y(child0));
  label_y_bounce_anim_init1(child0, random(-5, 5));

  lv_anim_t *b = lv_anim_get(child0, label_x_bounce_anim_cb1);
  if (b != NULL) return; // 如果动画正在播放，直接返回
  //Serial.printf("x:%d\n",lv_obj_get_x(child0));
  label_x_bounce_anim_init1(child0, random(-10, 10));
}

// 动画回调 关闭全局抖动
void offGlobalJitter_anim_cb(lv_anim_t *a)
{
  eep_doudong = 0;
}
// 事件回调 关闭全局抖动
void offGlobalJitter_event_cb(lv_event_t *e) 
{
  uint16_t *data = (uint16_t *)lv_event_get_user_data(e);
  uint16_t i = data[0];
  if (i > 0)
  {
    // 创建一个单次定时器
    lv_timer_t *timer = lv_timer_create(offGlobalJitter_timer_cb, 200, NULL);
    lv_timer_set_repeat_count(timer, 1);
    lv_timer_set_auto_delete(timer, true);
  }
  else eep_doudong = 0;
  //Serial.printf("eep_doudong:%d\n",eep_doudong);
}
// 定时器回调 关闭全局抖动
void offGlobalJitter_timer_cb(lv_timer_t *e) 
{
  eep_doudong = 0;
  //Serial.printf("eep_doudong:%d\n",eep_doudong);
}
// 定时开启全局抖动
void onGlobalJitter(uint16_t time)
{
  eep_doudong = 1; // 打开全局抖动
  // 一段时间后关闭全局抖动
  uint32_t time1 =0;
  if(time > 0) time1 = time;
  else         time1 = GRADUAL_ANIM_TIME - 100;
  // 创建一个单次定时器
  lv_timer_t *timer = lv_timer_create(offGlobalJitter_timer_cb, GRADUAL_ANIM_TIME - 100, NULL);
  lv_timer_set_repeat_count(timer, 1);
  lv_timer_set_auto_delete(timer, true);
}
// 获取上一个界面的焦点索引值并聚焦
void focusPosOld_return()
{
  //Serial.print("get_focusPos_old[" + String(focusPos_old_index) + "]:");
  //Serial.println(focusPos_old[focusPos_old_index]);
  if (focusPos_old_index <= -1) return;
  if (focusPos_old[focusPos_old_index] >= 0)
  {
    lv_obj_t *child = lv_obj_get_child(page.p[page.index], focusPos_old[focusPos_old_index]);
    lv_obj_set_state(child, LV_STATE_PRESSED, false); // 取消按下状态
    lv_group_focus_obj(child);                        // 聚焦
    LV_UNUSED(child);
  }
  focusPos_old_index--;
}
// 保存上一个界面的焦点索引值
void focusPosOld_save()
{
  focusPos_old_index++;
  lv_obj_t *focused_obj = lv_group_get_focused(group_my);
  if (focused_obj == NULL) focusPos_old[focusPos_old_index] = -1; // 如果没有聚焦对象，返回-1
  else                     focusPos_old[focusPos_old_index] = lv_obj_get_index(focused_obj);
  //Serial.printf("save_focusPos_old[%d]:%d\n", focusPos_old_index, focusPos_old[focusPos_old_index]);
}

//****** 全局抖动演示界面
void display_jitterSet_event(lv_event_t *e)
{
  lv_event_code_t code = lv_event_get_code(e);
  lv_obj_t *obj = lv_event_get_target_obj(e);
  //Serial.print("code:");Serial.println(code);
  if (code == LV_EVENT_VALUE_CHANGED) //对象的值已更改（即滑块已移动）
  {
    bool state = lv_obj_has_state(obj, LV_STATE_CHECKED);
    eep_doudong = state;
    //LV_LOG_USER("State: %s\n", state ? "On" : "Off");
  }
  else if(code == LV_EVENT_DEFOCUSED)
  {
    //lv_group_remove_all_objs(group_my); // 从组中删除所有对象
    //Serial.print("全局抖动code:");Serial.println(code);
    uint8_t key = lv_indev_get_key(lv_indev_active());
    //Serial.print("全局抖动key:");Serial.println(key);
    if (key == LV_KEY_NEXT)
    {
      display_mainSet_init();
      lv_screen_load_anim(page.p[page.index], LV_SCR_LOAD_ANIM_MOVE_TOP, PAGE_SWITCH_ANIM_TIME, 0, true);
    }
    else if (key == LV_KEY_PREV)
    {
      display_acc_init();
      lv_screen_load_anim(page.p[page.index], LV_SCR_LOAD_ANIM_MOVE_BOTTOM, PAGE_SWITCH_ANIM_TIME, 0, true);
      bitWrite(backgroundTask, BGT_ACC_READ, 1); // 打开加速度读取任务
    }
  }
  LV_UNUSED(obj);
}
void display_jitterSet_init()
{
  eepSavePage(page_jitterSet);

  uint8_t index = pageInit(KEY_MODE_PN, FIRST_EVENT_OFF);
  page.p[index] = lv_obj_create(NULL);
  lv_obj_set_size(page.p[index], TFT_HOR_RES, TFT_VER_RES);
  //lv_obj_align(page1, LV_ALIGN_CENTER, 0, 0);
  lv_obj_set_scrollbar_mode(page.p[index], LV_SCROLLBAR_MODE_OFF); //关闭滑动条

  //lv_obj_t *page1 = lv_screen_active();
  //page1 = lv_screen_active();
  //lv_obj_set_scrollbar_mode(page1, LV_SCROLLBAR_MODE_OFF); // 关闭滑动条
  
  LV_IMG_DECLARE(qft);
  lv_obj_t *gif = lv_gif_create(page.p[index]);
  lv_gif_set_src(gif, &qft);
  lv_obj_align(gif, LV_ALIGN_BOTTOM_MID, 0, 0);

  // 基本对象
  lv_obj_t *obj1 = lv_obj_create(page.p[index]);
  lv_obj_align(obj1, LV_ALIGN_TOP_MID, 0, 0);
  lv_obj_set_size(obj1, 72, 30);
  lv_obj_set_style_bg_color(obj1, MY_COLOR_GREEN, LV_STATE_DEFAULT);
  lv_obj_set_scrollbar_mode(obj1, LV_SCROLLBAR_MODE_OFF); // 关闭滑动条
  // 设置标签
  lv_obj_t *label = lv_label_create(obj1);
  lv_label_set_long_mode(label, LV_LABEL_LONG_SCROLL_CIRCULAR);
  lv_obj_align(label, LV_ALIGN_CENTER, 0, 0);
  lv_obj_set_width(label, 72);
  lv_label_set_text(label, "Arduino LVGL9");
  //lv_obj_set_style_text_font(label, &MISans_1, 0);

  // lv_obj_set_flex_flow(lv_screen_active(), LV_FLEX_FLOW_COLUMN);
  //lv_obj_set_flex_align(lv_screen_active(), LV_FLEX_ALIGN_CENTER, LV_FLEX_ALIGN_CENTER, LV_FLEX_ALIGN_CENTER);
  
  //使用新样式创建标签
  lv_obj_t *label2 = lv_label_create(page.p[index]);
  //lv_obj_set_style_text_font(label2, &MISans_1, 0);
  lv_label_set_long_mode(label2, LV_LABEL_LONG_SCROLL_CIRCULAR);
  lv_obj_set_style_anim_duration(label2, 3000, 0);
  lv_obj_set_width(label2, 43);
  lv_label_set_text(label2, String(F("抖动演示")).c_str());
  lv_obj_center(label2);
  lv_obj_align(label2, LV_ALIGN_LEFT_MID, 1, -20);

  // 创建开关
  lv_obj_t *sw = lv_switch_create(page.p[index]);
  lv_obj_align(sw, LV_ALIGN_RIGHT_MID, -4, -20);
  lv_obj_set_size(sw, 20, 11);
  lv_obj_set_style_bg_color(sw, lv_color_hex(0xff0000), LV_PART_MAIN); //开关 关闭的背景颜色
  lv_obj_set_style_bg_color(sw, lv_color_hex(0x00ffff), LV_PART_INDICATOR | LV_STATE_CHECKED); //开关 打开的背景颜色
  lv_obj_set_style_bg_color(sw, lv_color_hex(0xffffff), LV_PART_KNOB); //手柄颜色
  
  // 设置聚焦样式
  lv_obj_set_style_outline_width(sw, 2, LV_STATE_FOCUS_KEY);                      // 聚焦框的宽度
  lv_obj_set_style_outline_pad(sw, 1, LV_STATE_FOCUS_KEY);                        // 聚焦框的间隙
  lv_obj_set_style_outline_opa(sw, LV_OPA_100, LV_STATE_FOCUS_KEY);               // 聚焦框的不透明度
  lv_obj_set_style_outline_width(sw, 0, LV_PART_MAIN);                            // 失焦时的宽度
  lv_obj_set_style_outline_color(sw, MY_COLOR_BLACK, LV_STATE_FOCUS_KEY); // 聚焦框颜色

  lv_obj_add_event_cb(sw, display_jitterSet_event, LV_EVENT_VALUE_CHANGED, NULL); // 开关改变触发时的回调函数
  lv_obj_add_event_cb(sw, display_jitterSet_event, LV_EVENT_DEFOCUSED, NULL);     // 开关失焦触发时的回调函数
  lv_obj_add_flag(sw, LV_OBJ_FLAG_EVENT_BUBBLE);                                  // ?设置一个或多个标志
  if (eep_doudong) lv_obj_add_state(sw, LV_STATE_CHECKED); // 添加状态

  lv_group_add_obj(group_my, sw);    // 将对象邦定到组
  lv_group_add_obj(group_my, page.p[index]); // 将对象邦定到组
  
  // 设置初始焦点对象
  lv_group_focus_obj(sw);
}

//********** 图片界面
void display_picture_msgbox_cb(lv_event_t *e) 
{
  uint8_t *data = (uint8_t *)lv_event_get_user_data(e);
  if (data[0] == 0) // 退出
  {
    eep_doudong = 0;
   my_msgbox_exit(5); // 退出弹窗
    //Serial.printf("RTC_disPage_old:%d\n", RTC_disPage_old);
    if (RTC_disPage_old == page_fileExplorer)
    {
      // 回到上一个界面
      display_fileExplorer_init();
      lv_screen_load_anim(page.p[page.index], LV_SCR_LOAD_ANIM_FADE_OUT, 500, 0, true);
      onGlobalJitter(400);  // 打开全局抖动
      //focusPosOld_return(); // 回到刚才的焦点
      lv_obj_t *child = lv_obj_get_child(page.p[page.index], focusPos_old[focusPos_old_index + 1]);
      lv_obj_set_state(child, LV_STATE_PRESSED, false); // 取消按下状态
      lv_group_focus_obj(child);                        // 聚焦
      LV_UNUSED(child);
      /*for (uint8_t i = 0; i < 10; i++)
      {
        Serial.printf("focusPos_old[%d]:%d\n", i, focusPos_old[i]);
      }
      Serial.printf("focusPos_old[%d]:%d\n", focusPos_old_index, focusPos_old[focusPos_old_index]);
      */
    }
  }
  else if (data[0] == 1) // 返回
  {
   my_msgbox_exit(0); // 退出弹窗
  }
}
void display_picture_event_msgbox(lv_event_t *e) // 当屏幕被聚焦时，弹出退出弹窗
{
  uint8_t key = lv_indev_get_key(lv_indev_active());
  // Serial.printf("key:%d", key);
  if (key == LV_KEY_RIGHT || key == LV_KEY_LEFT)
  {
    my_msgbox_send(F("图片"), F("查看器"), 0, F("退出\n返回\n"), display_picture_msgbox_cb);
  }
}
// 图片路径 抖动使能 退出菜单使能
void display_picture_init(String path, bool doudong = 1, bool menu = 0)
{
  eepSavePage(page_picture, 0);

  pageInit(KEY_MODE_RL, FIRST_EVENT_OFF);
  page.p[page.index] = lv_obj_create(NULL);
  lv_obj_set_style_pad_top(page.p[page.index], 0, LV_STATE_DEFAULT);
  lv_obj_set_style_pad_bottom(page.p[page.index], 0, LV_STATE_DEFAULT);
  lv_obj_set_scrollbar_mode(page.p[page.index], LV_SCROLLBAR_MODE_OFF); // 关闭滑动条
  path = "A:" + path;
  lv_obj_t *wp = lv_image_create(page.p[page.index]);
  lv_image_set_src(wp, path.c_str());
  lv_obj_center(wp);

  if (doudong) // 需要抖动
  {
    // uint16_t *delay1 = (uint16_t *)malloc(1 * sizeof(uint16_t));
    // lv_obj_add_event_cb(page.p[page.index], offGlobalJitter_event_cb, LV_EVENT_SCREEN_LOADED, &delay1);
    eep_doudong = doudong;
  }
  if (menu) // 需要返回菜单
  {
    lv_group_add_obj(group_my, page.p[page.index]);
    lv_obj_add_event_cb(page.p[page.index], display_picture_event_msgbox, LV_EVENT_KEY, NULL);
  }
}

//********** 屏幕保护界面
// 创建定时器
void display_screenSaver_timer_cb(lv_timer_t *e) 
{
  static uint8_t colorIndex = 0;
  lv_color_t color[8] = {MY_COLOR_WHITE, MY_COLOR_GREEN, MY_COLOR_YELLOW,
                         MY_COLOR_MAGENTA, MY_COLOR_BLUE, MY_COLOR_RED,
                         MY_COLOR_BLACK, MY_COLOR_CYAN};
  lv_obj_set_style_bg_color(page.p[page.index], color[colorIndex % 8], 0);
  colorIndex++;
  //if (colorIndex % 2) jdi_display.displayOff();
  //else jdi_display.displayOn();
  //Serial.printf("colorIndex:%d\n", colorIndex);
  if (colorIndex >= 16)
  {
    colorIndex = 0;
    display_clock_init();
    lv_screen_load_anim(page.p[page.index], LV_SCR_LOAD_ANIM_FADE_IN, GRADUAL_ANIM_TIME, 0, true);
    onGlobalJitter(); // 打开全局抖动
  }
}
void display_screenSaver_init()
{
  pageInit(KEY_MODE_RL, FIRST_EVENT_OFF);
  page.p[page.index] = lv_obj_create(NULL);
  lv_obj_set_style_bg_color(page.p[page.index], MY_COLOR_CYAN, 0);
  // 创建一个定时器
  lv_timer_t *timer = lv_timer_create(display_screenSaver_timer_cb, 100, NULL);
  lv_timer_set_repeat_count(timer, 16);
  lv_timer_set_auto_delete(timer, true);
}

//****** 设置菜单
void display_mainSet_event2(lv_event_t *e) // 自动设置滚动方式的事件
{
  lv_event_code_t code = lv_event_get_code(e);
  lv_obj_t *obj = lv_event_get_target_obj(e);
  if (key_code == LV_KEY_PREV) // 上一个
  {
    // lv_obj_t *focused_obj = lv_group_get_focused(group_my);
    // int focusPos = lv_obj_get_index(focused_obj);
    // Serial.print("focusPos1:"); Serial.println(focusPos);
    lv_obj_set_scroll_snap_y(page.p[page.index], LV_SCROLL_SNAP_NONE); // 不要对齐，留在原地
    int top = lv_obj_get_scroll_top(page.p[page.index]);
    lv_obj_scroll_by(page.p[page.index], 0, top, LV_ANIM_ON);
  }
  else if (key_code == LV_KEY_NEXT) // 下一个
  {
    lv_obj_set_scroll_snap_y(page.p[page.index], LV_SCROLL_SNAP_CENTER);  // 对齐中心
  }

  // lv_obj_update_layout(page.p[page.index]);
  // int16_t scroll_y = lv_obj_get_scroll_y(page.p[page.index]);
  // Serial.printf("scroll_y:%d\n",scroll_y);
}
void mainSet_event3_anim_cb(void *var, int32_t v)
{
 lv_obj_align((lv_obj_t *)var, LV_ALIGN_CENTER, 0, v);
}
void display_mainSet_event3(lv_event_t *e) // 最后一个对象聚焦时弹出版本和作者
{
  if (lv_obj_has_flag(label_share[0], LV_OBJ_FLAG_HIDDEN))
  {
    lv_anim_t a;
    lv_anim_init(&a);                                // 动画初始化
    lv_anim_set_var(&a, label_share[1]);             // 设置需要动画的对象
    lv_anim_set_values(&a, 60, 0);                   // 设置动画的开始值和结束值
    lv_anim_set_duration(&a, 300);                   // 设置动画的持续时间
    lv_anim_set_delay(&a, 300);                      // 在开始动画之前设置延迟
    lv_anim_set_exec_cb(&a, mainSet_event3_anim_cb); // 设置需要变化的值
    lv_anim_set_path_cb(&a, lv_anim_path_ease_out );    // 设置变化特效
    // lv_anim_set_completed_cb(&a, button_width_shrink_anim_end_cb); // 设置动画完成时的函数调用
    //  lv_anim_set_user_data(&a, user_data);                       // 添加当前的用户数据
    lv_anim_start(&a);
    lv_obj_remove_flag(label_share[0], LV_OBJ_FLAG_HIDDEN);
  }
}
void display_mainSet_EVENT_FOCUSED(lv_event_t *e) // page聚焦切换上一个界面
{
  Serial.println("page聚焦");
  uint8_t key = lv_indev_get_key(lv_indev_active());
  
  //****** page聚焦切换页面
  if (key == LV_KEY_PREV) //上一个焦点
  {
    display_jitterSet_init();
    lv_screen_load_anim(page.p[page.index], LV_SCR_LOAD_ANIM_MOVE_BOTTOM, PAGE_SWITCH_ANIM_TIME, 0, true);
  }
  if (page.firstEvent) // 首次进入该事件时 
  {
    //page.firstEvent = 0;

    // 手动定位到第一个焦点
    /*lv_obj_t *child = lv_obj_get_child(page.p[page.index], 0);
    lv_group_focus_obj(child);
    */
    // 设置滚动模式-不要对齐，留在原地
    //lv_obj_set_scroll_snap_y(page.p[page.index], LV_SCROLL_SNAP_NONE);
  }
}
void display_mainSet_EVENT_DEFOCUSED(lv_event_t *e) // page失焦 设置滚动对齐方式
{
  Serial.println("page失焦");
  uint8_t key = lv_indev_get_key(lv_indev_active());

  //****** page聚焦切换页面
  if (key == LV_KEY_PREV) // 上一个
  {
    lv_obj_set_scroll_snap_y(page.p[page.index], LV_SCROLL_SNAP_CENTER);
  }
  else if (key == LV_KEY_NEXT) // 下一个
  {
    lv_obj_set_scroll_snap_y(page.p[page.index], LV_SCROLL_SNAP_NONE);
  }
}
void display_mainSet_event_skip(lv_event_t *e) // 跳转事件1
{
  uint8_t *data = (uint8_t *)lv_event_get_user_data(e);
  uint8_t i = data[0];
  Serial.printf("跳转事件:%d\n", i);
  uint8_t index = 0;
  if      (i == index++) // 跳转配网界面
  {
    bitWrite(backgroundTask, BGT_CONFIG_NETWORK, 1);
  }
  else if (i == index++) // 跳转休眠设置界面
  {
    focusPosOld_save(); // 保存上一个界面的焦点
    display_sleepSet_init();
    lv_screen_load_anim(page.p[page.index], LV_SCR_LOAD_ANIM_FADE_IN, GRADUAL_ANIM_TIME, 0, true);
    onGlobalJitter(); // 打开全局抖动
  }
  else if (i == index++) // wifi选择界面
  {
    File file = LittleFS.open(wifiRecord, "r");
    if (!file)
    {
      my_msgbox_send(F("WIFI"), F("无记录"), 1000);
      return;
    }
    String str;
    for (uint16_t i = 0; i < file.size(); i++)
      str += char(file.read());
    file.close();
    focusPosOld_save(); // 保存上一个界面的焦点
    display_wifiSelect_init(str);
    lv_screen_load_anim(page.p[page.index], LV_SCR_LOAD_ANIM_FADE_IN, GRADUAL_ANIM_TIME, 0, true);
    onGlobalJitter(); // 打开全局抖动
  }
  else if (i == index++) // 时钟设置界面
  {
    focusPosOld_save(); // 保存上一个界面的焦点
    display_clockSet_init();
    lv_screen_load_anim(page.p[page.index], LV_SCR_LOAD_ANIM_FADE_IN, GRADUAL_ANIM_TIME, 0, true);
    onGlobalJitter(); // 打开全局抖动
  }
  else if (i == index++) // 跳转文件管理器界面
  {
    focusPosOld_save(); // 保存上一个界面的焦点
    fileManagerInit(1); // 耗时30ms，应考虑放到后台任务执行
    display_fileExplorer_init();
    lv_screen_load_anim(page.p[page.index], LV_SCR_LOAD_ANIM_FADE_IN, GRADUAL_ANIM_TIME, 0, true);
    onGlobalJitter(); // 打开全局抖动
  }
  else if (i == index++) // 闹钟界面
  {
    focusPosOld_save();              // 保存上一个界面的焦点
    display_alarmClock_init();
    lv_screen_load_anim(page.p[page.index], LV_SCR_LOAD_ANIM_FADE_IN, GRADUAL_ANIM_TIME, 0, true);
    onGlobalJitter(); // 打开全局抖动
  }
  else if (i == index++) // 蜂鸣器
  {
    //alarmClockTimeDifference(0);
    //i2s_playSpecified("/op.mid");
    //delay(1000);
    
    /*note_t note[12] = {NOTE_C, NOTE_Cs, NOTE_D, NOTE_Eb, NOTE_E, NOTE_F, NOTE_Fs, NOTE_G, NOTE_Gs, NOTE_A, NOTE_Bb, NOTE_B};
    ledcWriteNote(BUZZER_CHANNEL, note[3], 4);
    delay(100);
    ledcWriteNote(BUZZER_CHANNEL, note[4], 4);
    delay(150);
    ledcWriteNote(BUZZER_CHANNEL, note[3], 6);
    delay(200);
    ledcWrite(BUZZER_CHANNEL, 0);*/
    focusPosOld_save(); //保存上一个界面的焦点
    display_buzzerSet_init();
    lv_screen_load_anim(page.p[page.index], LV_SCR_LOAD_ANIM_FADE_IN, GRADUAL_ANIM_TIME, 0, true);
    onGlobalJitter(); // 打开全局抖动
  }
  else if (i == index++) // 电量计
  {
    // 检查电量计是否存在
    if (i2cChipExist(BATSOC_I2C_ADDR) == 0)
    {
      my_msgbox_forceSend(F("电量计"), F("不存在"), 0, F("退出\n"), msgbox_exit_cb);
      return;
    }

    focusPosOld_save(); // 保存上一个界面的焦点
    display_batSOC_init();
    lv_screen_load_anim(page.p[page.index], LV_SCR_LOAD_ANIM_FADE_IN, GRADUAL_ANIM_TIME, 0, true);
    onGlobalJitter(); // 打开全局抖动
  }
  else if (i == index++) // 跳转空气质量界面
  {
    //display_screenSaver_init();
    //lv_screen_load_anim(page.p[page.index], LV_SCR_LOAD_ANIM_OVER_LEFT, 100, 0, true);
    //my_msgbox_forceSend(F("空气模块"), F("未完成"), 0, F("退出\n"), msgbox_exit_cb);

    /*focusPosOld_save(); // 保存上一个界面的焦点
    display_keyADC_cali_init();
    lv_screen_load_anim(page.p[page.index], LV_SCR_LOAD_ANIM_FADE_IN, GRADUAL_ANIM_TIME, 0, true);
    onGlobalJitter(); // 打开全局抖动
    */

    /*bitWrite(backgroundTask, BGT_AIR_READ, 1);
    focusPosOld_save(); //保存上一个界面的焦点
    display_air_init();
    lv_screen_load_anim(page.p[page.index], LV_SCR_LOAD_ANIM_FADE_IN, GRADUAL_ANIM_TIME, 0, true);
    onGlobalJitter(); // 打开全局抖动
    */

    bitWrite(backgroundTask, BGT_AIR_READ, 1); // 打开串口任务
    bitWrite(backgroundTask, BGT_MQTT, 1);     // 打开MQTT任务
    focusPosOld_save(); // 保存上一个界面的焦点
    display_uartAir_init();
    lv_screen_load_anim(page.p[page.index], LV_SCR_LOAD_ANIM_FADE_IN, GRADUAL_ANIM_TIME, 0, true);
    onGlobalJitter(); // 打开全局抖动
  }
  else if (i == index++) // 位置信息
  {
    //my_msgbox_forceSend(F("北斗模块"), F("未插入"), 0, F("退出\n"), msgbox_exit_cb);
    //box2d_world_init();
    
    // 打开定位信息读取任务
    bitWrite(backgroundTask, BGT_LOCATE_INFO_READ, 1);
    focusPosOld_save(); // 保存上一个界面的焦点
    display_locateInfo_init();
    lv_screen_load_anim(page.p[page.index], LV_SCR_LOAD_ANIM_FADE_IN, GRADUAL_ANIM_TIME, 0, true);
    onGlobalJitter(); // 打开全局抖动
  }
  else if (i == index++) // 码表界面
  {
    //my_msgbox_forceSend(F("北斗模块"), F("未插入"), 0, F("退出\n"), msgbox_exit_cb);
    //box2d_world_init();
    
    // 打开定位信息读取任务
    bitWrite(backgroundTask, BGT_LOCATE_INFO_READ, 1);
    focusPosOld_save(); // 保存上一个界面的焦点
    display_stopwatch_init();
    lv_screen_load_anim(page.p[page.index], LV_SCR_LOAD_ANIM_FADE_IN, GRADUAL_ANIM_TIME, 0, true);
    onGlobalJitter(); // 打开全局抖动
  }
  else if (i == index++) // 备忘录设置界面
  {
    focusPosOld_save(); // 保存上一个界面的焦点
    display_memoSet_init();
    lv_screen_load_anim(page.p[page.index], LV_SCR_LOAD_ANIM_FADE_IN, GRADUAL_ANIM_TIME, 0, true);
    onGlobalJitter(); // 打开全局抖动
  }
  else if (i == index++) // 前置光界面
  {
    focusPosOld_save(); // 保存上一个界面的焦点
    display_frontLightSet_init();
    lv_screen_load_anim(page.p[page.index], LV_SCR_LOAD_ANIM_FADE_IN, GRADUAL_ANIM_TIME, 0, true);
    onGlobalJitter(); // 打开全局抖动
    
    //打开环境光读取
    bitWrite(backgroundTask, BGT_AMBIENT_LIGHT, 1); 
  }
  else if (i == index++) // 今日宜忌
  {
    bitWrite(backgroundTask, BGT_GET_WanNianLi, 1);
  }
  else if (i == index++) // 打开 检查更新 任务
  {
    bitWrite(backgroundTask, BGT_CHECK_UPDATE, 1);
  }
}
void display_mainSet_init()
{
  eepSavePage(page_mainSet);

  pageInit(KEY_MODE_PN, FIRST_EVENT_OFF);
  page.p[page.index] = lv_obj_create(NULL);
  lv_obj_set_scrollbar_mode(page.p[page.index], LV_SCROLLBAR_MODE_OFF); //关闭滑动条
  //lv_obj_set_scroll_snap_y(page.p[page.index], LV_SCROLL_SNAP_CENTER);
  lv_obj_set_style_pad_top(page.p[page.index], 5, LV_STATE_DEFAULT);
  lv_obj_set_style_pad_bottom(page.p[page.index], 5, LV_STATE_DEFAULT);

  lv_obj_set_flex_flow(page.p[page.index], LV_FLEX_FLOW_COLUMN);
  //参数2：将项目放置在主轴上的位置（在其轨迹中）。lv_flex_align_t的任何值    控制Y轴排布
  //参数3：在横轴上的轨迹中放置项目的位置。LV_FLEX_ALIGN_START/END/CENTER    
  //参数4：在交叉方向上放置轨道的位置。lv_flex_align_t的任何值。             控制X轴排布
  lv_obj_set_flex_align(page.p[page.index], LV_FLEX_ALIGN_START, LV_FLEX_ALIGN_CENTER, LV_FLEX_ALIGN_CENTER);
  //lv_obj_set_flex_grow(page2, 5);
  
  // 设置垂直滚动结束时捕捉子对象的位置
  lv_obj_set_scroll_snap_y(page.p[page.index], LV_SCROLL_SNAP_NONE);  // 不要对齐，留在原地

  String obj_name[15];
  uint8_t count = 0;
  obj_name[count++] = F("配网");
  obj_name[count++] = F("休眠设置");
  obj_name[count++] = F("WiFi选择");
  obj_name[count++] = F("时钟校准");
  obj_name[count++] = F("文件\n管理器");
  obj_name[count++] = F("闹钟");
  obj_name[count++] = F("蜂鸣器");
  obj_name[count++] = F("电量计");
  obj_name[count++] = F("空气质量");
  obj_name[count++] = F("位置信息");
  obj_name[count++] = F("码表");
  obj_name[count++] = F("备忘录");
  obj_name[count++] = F("前置光");
  obj_name[count++] = F("今日宜忌");
  obj_name[count++] = F("检查更新");

  lv_obj_t *but[count];
  lv_obj_t *label[count];
  for (uint8_t i = 0; i < count; i++)
  {
    // 将项目添加到列
    but[i] = lv_button_create(page.p[page.index]);
    uint16_t text_width = lv_text_get_width(obj_name[i].c_str(), obj_name[i].length(), lv_obj_get_style_text_font(but[i], 0), 0);
    uint16_t text_width_zl =  text_width / 65;
    lv_obj_set_size(but[i], 68, 22 + (text_width_zl * 20));
    //lv_obj_align(but[i], LV_ALIGN_CENTER, 0, 0); // 对齐方式
    lv_obj_add_style(but[i], &style_shadow, LV_STATE_ANY); // 移除阴影

    // 青色和绿色交替
    if (!(i & 1)) //  偶数
      lv_obj_set_style_bg_color(but[i], MY_COLOR_CYAN, LV_STATE_DEFAULT);
    else
      lv_obj_set_style_bg_color(but[i], MY_COLOR_GREEN, LV_STATE_DEFAULT);

    lv_obj_set_style_outline_width(but[i], 2, LV_STATE_FOCUS_KEY);              // 聚焦框的宽度
    lv_obj_set_style_outline_pad(but[i], 0, LV_STATE_FOCUS_KEY);                // 聚焦框的间隙
    lv_obj_set_style_outline_opa(but[i], LV_OPA_100, LV_STATE_FOCUS_KEY);       // 聚焦框的不透明度
    lv_obj_set_style_outline_width(but[i], 0, LV_STATE_DEFAULT);                // 失焦时的宽度
    lv_obj_set_style_outline_color(but[i], MY_COLOR_BLACK, LV_STATE_FOCUS_KEY); // 聚焦框颜色

    lv_obj_set_style_border_width(but[i], 1, 0);                // 设置边框宽度
    lv_obj_set_style_border_color(but[i], MY_COLOR_MAGENTA, 0); // 设置边框颜色

    // 标签对象
    label[i] = lv_label_create(but[i]); // 创建标签
    lv_obj_set_width(label[i], 66);
    lv_obj_align(label[i], LV_ALIGN_CENTER, 0, 0);        // 对齐方式
    lv_label_set_long_mode(label[i], LV_LABEL_LONG_WRAP); // 设置文本长字符模式
    lv_obj_set_style_text_align(label[i], LV_TEXT_ALIGN_CENTER, 0);
    // lv_label_set_text_fmt(label[i], obj_name[i].c_str(), timeArray[i]); // 标签文本
    lv_label_set_text(label[i], obj_name[i].c_str()); // 标签文本
    lv_obj_set_style_text_color(label[i], MY_COLOR_BLACK, LV_STATE_DEFAULT);

    lv_group_add_obj(group_my, but[i]);                                                 // 将对象邦定到组
    lv_obj_add_event_cb(but[i], buttonFocus_anim_event, LV_EVENT_FOCUSED, NULL);        // 按钮聚焦动画
    lv_obj_add_event_cb(but[i], display_mainSet_event_skip, LV_EVENT_PRESSED, &num[i]); // 按钮按下事件
  }
  lv_obj_add_event_cb(but[count - 1], display_mainSet_event3, LV_EVENT_FOCUSED, NULL); // 弹窗作者和版本的事件

  // 自动设置滚动方式的事件
  lv_obj_add_event_cb(but[1], display_mainSet_event2, LV_EVENT_FOCUSED, NULL);   // 聚焦事件
  lv_obj_add_event_cb(but[1], display_mainSet_event2, LV_EVENT_DEFOCUSED, NULL); // 失焦事件

  /*
    // 无空气质量传感器，隐藏对象
  #if AIR_TYPE == 0
        lv_obj_add_flag(but[5], LV_OBJ_FLAG_HIDDEN);
        lv_obj_add_flag(but[11], LV_OBJ_FLAG_HIDDEN);
  #endif
  #if FUEL_GAUGE_TYPE == 0
        lv_obj_add_flag(but[7], LV_OBJ_FLAG_HIDDEN);
  #endif
  */
  //lv_obj_update_layout(page.p[page.index]);
  //int32_t num = lv_obj_get_child_count(page.p[page.index]);
  //LV_LOG_USER("page.p[page.index]对象数量:%u", num);

  // 将对象邦定到组
  lv_group_add_obj(group_my, page.p[page.index]);
  // 聚焦触发 切换页面
  lv_obj_add_event_cb(page.p[page.index], display_mainSet_EVENT_FOCUSED, LV_EVENT_FOCUSED, NULL);
  lv_obj_add_event_cb(page.p[page.index], display_mainSet_EVENT_DEFOCUSED, LV_EVENT_DEFOCUSED, NULL);

  lv_obj_t *label_bottom;
  label_share[0] = lv_obj_create(page.p[page.index]);
  lv_obj_set_size(label_share[0], 80, 45);
  lv_obj_add_style(label_share[0], &style_shadow, LV_STATE_ANY);      // 移除阴影
  lv_obj_add_style(label_share[0], &style_squareShape, LV_STATE_ANY); // 设置为方形
  lv_obj_set_style_bg_opa(label_share[0], LV_OPA_0, 0);

  label_share[1] = lv_obj_create(label_share[0]);
  lv_obj_set_size(label_share[1], 80, 45);
  lv_obj_align(label_share[1], LV_ALIGN_CENTER, 0, 0); // 对齐方式
  lv_obj_add_style(label_share[1], &style_shadow, LV_STATE_ANY); // 移除阴影     
  lv_obj_add_style(label_share[1], &style_squareShape, LV_STATE_ANY); // 设置为方形
  lv_obj_set_style_bg_color(label_share[1], MY_COLOR_MAGENTA, LV_STATE_DEFAULT);

  // 标签对象 
  label_bottom = lv_label_create(label_share[1]);                      // 创建标签
  lv_label_set_long_mode(label_bottom, LV_LABEL_LONG_SCROLL_CIRCULAR); // 长字符模式
  lv_obj_set_style_anim_duration(label_bottom, 3000, 0);               // 滚动时间
  lv_obj_set_width(label_bottom, 70);                                  // 设置宽度
  lv_label_set_text(label_bottom, String(F("By 甘草酸不酸")).c_str());
  lv_obj_set_style_text_color(label_bottom, MY_COLOR_WHITE, 0);
  lv_obj_align(label_bottom, LV_ALIGN_LEFT_MID, -12, -9); // 对齐方式
  // 标签对象
  label_bottom = lv_label_create(label_share[1]); // 创建标签
  lv_obj_set_style_text_align(label_bottom, LV_TEXT_ALIGN_CENTER, 0); // 文本对齐方式
  lv_label_set_text(label_bottom, version);                           // 标签文本
  lv_obj_set_style_text_color(label_bottom, MY_COLOR_WHITE, 0);       // 文本颜色
  lv_obj_align(label_bottom, LV_ALIGN_CENTER, 0, 10);                 // 对齐方式
  lv_obj_add_flag(label_share[0], LV_OBJ_FLAG_HIDDEN); // 隐藏对象

  //lv_obj_update_layout(page.p[page.index]);
  // 设置按钮为可聚焦状态
  // lv_obj_add_state(but[0], LV_STATE_FOCUS_KEY);
  // lv_group_focus_obj(but[0]); // 将焦点设为第一个子对象处
  // lv_group_focus_next(group_my);
}

//****** 加速度计界面
float roll_zero = 0.0;  // 俯仰零点
float pitch_zero = 0.0; // 横滚零点
void updateAcc_timer_cb(lv_timer_t *time) // 定时更新加速度数据
{
  if (eep_disPage != page_acc)
  {
    bitWrite(backgroundTask, BGT_ACC_READ, 0); // 标记关闭
    return;
  }

  if (eep_accDispMod == 0) // 原始数据
  {
    lv_label_set_text_fmt(label_share[0], "X:%d", acc.x);
    lv_label_set_text_fmt(label_share[1], "Y:%d", acc.y);
    lv_label_set_text_fmt(label_share[2], "Z:%d", acc.z);
  }
  else if (eep_accDispMod == 1)  // 原始滤波数据
  {
    lv_label_set_text_fmt(label_share[0], "X:%d", acc.x);
    lv_label_set_text_fmt(label_share[1], "Y:%d", acc.y);
    lv_label_set_text_fmt(label_share[2], "Z:%d", acc.z);
  }
  else if (eep_accDispMod == 2)  // 角度原始数据
  {
     // 俯仰
     float roll = atan2(acc.y, acc.z) * 180.0 / PI;
     // 横滚
     float pitch = atan2(-acc.x, sqrt(acc.y * acc.y + acc.z * acc.z)) * 180.0 / PI;
     lv_label_set_text_fmt(label_share[0], "X:%.1f°", roll);
     lv_label_set_text_fmt(label_share[1], "Y:%.1f°", pitch);
     lv_label_set_text(label_share[2], "Z:N/A");
  }
  else if (eep_accDispMod == 3)  // 角度调零数据
  {
     // 俯仰
     float roll = atan2(acc.y, acc.z) * 180.0 / PI;
     roll -= roll_zero; // 补偿零点
     // 横滚
     float pitch = atan2(-acc.x, sqrt(acc.y * acc.y + acc.z * acc.z)) * 180.0 / PI;
     pitch -= pitch_zero; // 补偿零点
     lv_label_set_text_fmt(label_share[0], "X:%.1f°", roll);
     lv_label_set_text_fmt(label_share[1], "Y:%.1f°", pitch);
     lv_label_set_text(label_share[2], "Z:N/A");
  }
  /*char *c = (char *)lv_event_get_user_data(e);
  //lv_event_dsc_get_user_data
  lv_obj_t *obj = lv_event_get_target_obj(e);
  if     (c[0] == 'x') lv_label_set_text_fmt(obj, "X：%d", acc.x);
  else if(c[0] == 'y') lv_label_set_text_fmt(obj, "Y：%d", acc.y);
  else if(c[0] == 'z') lv_label_set_text_fmt(obj, "Z：%d", acc.z);*/
}
void display_acc_event(lv_event_t *e) //短按事件
{
  //lv_event_code_t code = lv_event_get_code(e);
  //lv_obj_t *obj = lv_event_get_target_obj(e);
  //Serial.print("acc code:");Serial.println(code);
  uint8_t key = lv_indev_get_key(lv_indev_active());
  //Serial.print("acc key:");Serial.println(key);
  if (key == LV_KEY_LEFT || key == LV_KEY_RIGHT)
  {
    // 删除定时器
    if (lvTimer_share[0] != NULL)
    {
      lv_timer_delete(lvTimer_share[0]);
      lvTimer_share[0] = NULL;
    }
    // 关闭加速度读取任务
    bitWrite(backgroundTask, BGT_ACC_READ, 0);
    if (key == LV_KEY_RIGHT)
    {
      display_jitterSet_init(); // 切换至抖动设置界面
      lv_screen_load_anim(page.p[page.index], LV_SCR_LOAD_ANIM_MOVE_TOP, PAGE_SWITCH_ANIM_TIME, 0, true);
    }
    else if(key == LV_KEY_LEFT)
    {
      display_clock_init(); // 切换至时钟界面
      lv_screen_load_anim(page.p[page.index], LV_SCR_LOAD_ANIM_MOVE_BOTTOM, PAGE_SWITCH_ANIM_TIME, 0, true);
      bitWrite(backgroundTask, BGT_CLOCK_READ, 1); //打开时钟读取任务
    }
  }
  else if(key == LV_KEY_ENTER)
  {
    /*while (getKey() == 1)
    {
      Serial.println("11111");
      vTaskDelay(1);
    }*/

    // 获取第4个子对象的子对象
    lv_obj_t *label = lv_obj_get_child(lv_obj_get_child(page.p[page.index], 4), 0); 

    lv_anim_t *a = lv_anim_get(label, label_y_bounce_anim_cb);
    if (a != NULL) return ; // 如果动画正在播放，直接返回

    buzzerSen(30);

    String text; 
    eep_accDispMod++;
    if (eep_accDispMod > 3) eep_accDispMod = 0;
    if      (eep_accDispMod == 0) text = F("原始");
    else if (eep_accDispMod == 1) text = F("原始滤波");
    else if (eep_accDispMod == 2) text = F("角度原始");
    else if (eep_accDispMod == 3) text = F("角度调零");
    lv_label_set_text(label, text.c_str());
    label_y_bounce_anim_init(label, 10);
    //uint8_t y = lv_obj_get_y(label_share[0]);
    //Serial.printf("label_share[0]_y:%d\n", y);

    // 添加随机跳动
    label_y_bounce_anim_init(label_share[0], random(-5, 5));
    label_y_bounce_anim_init(label_share[1], random(-5, 5));
    label_y_bounce_anim_init(label_share[2], random(-5, 5));
    label_x_bounce_anim_init(label_share[0], random(-5, 5));
    label_x_bounce_anim_init(label_share[1], random(-5, 5));
    label_x_bounce_anim_init(label_share[2], random(-5, 5));
    eepSaveState = 1; // 标记保存eeprom
  }
}
void acc_zero_cb() // 长按时间 蜂鸣器播放结束的回调
{
  //printf("音乐播放完成！\n");
  
   // 自动跳转至角度调零页面
  if (eep_disPage != page_acc)
  {
    bitWrite(backgroundTask, BGT_ACC_READ, 0); // 标记关闭
    return;
  }
  eep_accDispMod = 3;
  String text = F("角度调零");
  lv_obj_t *label = lv_obj_get_child(lv_obj_get_child(page.p[page.index], 4), 0);
  lv_anim_t *a = lv_anim_get(label, label_y_bounce_anim_cb);
  lv_label_set_text(label, text.c_str());
  label_y_bounce_anim_init(label, 10);
  // 添加随机跳动
  label_y_bounce_anim_init(label_share[0], random(-5, 5));
  label_y_bounce_anim_init(label_share[1], random(-5, 5));
  label_y_bounce_anim_init(label_share[2], random(-5, 5));
  label_x_bounce_anim_init(label_share[0], random(-5, 5));
  label_x_bounce_anim_init(label_share[1], random(-5, 5));
  label_x_bounce_anim_init(label_share[2], random(-5, 5));
  eepSaveState = 1; // 标记保存eeprom
  my_msgbox_send(F("角度"), F("调零完成"), 800);
  // 俯仰
  roll_zero = atan2(acc.y, acc.z) * 180.0 / PI;
  // 横滚
  pitch_zero = atan2(-acc.x, sqrt(acc.y * acc.y + acc.z * acc.z)) * 180.0 / PI;
}
void display_acc_event1(lv_event_t *e) // 长按事件
{
  //lv_event_code_t code = lv_event_get_code(e);
  //lv_obj_t *obj = lv_event_get_target_obj(e);
  //Serial.print("acc code:");Serial.println(code);
  uint8_t i = 0;
  uint16_t *melody = (uint16_t *)malloc((3 * 7 + 1) * sizeof(uint16_t)); //频率，时长，延时
  melody[i++] = 3500; melody[i++] = 100; melody[i++] = 60;
  melody[i++] = 4500; melody[i++] = 100; melody[i++] = 60;
  melody[i++] = 2000; melody[i++] = 150; melody[i++] = 300;

  melody[i++] = 3000; melody[i++] = 300; melody[i++] = 600;
  melody[i++] = 3000; melody[i++] = 300; melody[i++] = 600;
  melody[i++] = 3000; melody[i++] = 300; melody[i++] = 600;

  melody[i++] = 4900; melody[i++] = 500; melody[i++] = 800; 

  melody[i] = 0;
  buzzer_music_rtos_init(melody, acc_zero_cb);

  //uint8_t key = lv_indev_get_key(lv_indev_active());
  //Serial.print("key:");Serial.println(key);
}
void display_acc_init()
{
  eepSavePage(page_acc);

  LV_FONT_DECLARE(MiSans_Bold_16px);

  pageInit(KEY_MODE_RL, FIRST_EVENT_OFF);
  page.p[page.index] = lv_obj_create(NULL);
  lv_obj_set_size(page.p[page.index], TFT_HOR_RES, TFT_VER_RES);
  lv_obj_align(page.p[page.index], LV_ALIGN_CENTER, 0, 0);
  lv_obj_set_scrollbar_mode(page.p[page.index], LV_SCROLLBAR_MODE_OFF); //关闭滑动条
  lv_obj_set_style_pad_top(page.p[page.index], 0, LV_STATE_DEFAULT);
  lv_obj_set_style_pad_bottom(page.p[page.index], 0, LV_STATE_DEFAULT);

  lv_group_add_obj(group_my, page.p[page.index]); // 将对象邦定到组
  lv_obj_add_event_cb(page.p[page.index], display_acc_event, LV_EVENT_KEY, NULL);
  lv_obj_add_event_cb(page.p[page.index], display_acc_event1, LV_EVENT_LONG_PRESSED, NULL);

  lv_obj_t *title_bg;
  title_bg = lv_obj_create(page.p[page.index]);
  lv_obj_set_size(title_bg, 74, 30);
  lv_obj_align(title_bg, LV_ALIGN_TOP_MID, 0, 0);
  lv_obj_set_style_bg_color(title_bg, MY_COLOR_GREEN, 0);
  lv_obj_set_scrollbar_mode(title_bg, LV_SCROLLBAR_MODE_OFF); // 关闭滑动条
  lv_obj_add_style(title_bg, &style_shadow, 0);               // 添加阴影不透明度样式
  lv_obj_add_style(title_bg, &style_squareShape, 0);          // 添加方形样式
  lv_obj_t *title_label;
  title_label = lv_label_create(title_bg);
  lv_obj_align(title_label, LV_ALIGN_CENTER, 0, 0);
  lv_label_set_text(title_label, String("加速度计").c_str());

  lv_obj_t *obj[3];
  for (uint8_t i = 0; i < 3; i++)
  {
    // 对象
    obj[i] = lv_obj_create(page.p[page.index]);
    lv_obj_set_size(obj[i], 76, 30);
    lv_obj_align(obj[i], LV_ALIGN_TOP_MID, 0, (i + 1) * 30 + 2);
    lv_obj_set_style_bg_color(obj[i], MY_COLOR_CYAN, LV_STATE_DEFAULT);
    lv_obj_set_scrollbar_mode(obj[i], LV_SCROLLBAR_MODE_OFF);  // 关闭滑动条
    lv_obj_add_style(obj[i], &style_shadow, LV_STATE_DEFAULT); // 添加阴影不透明度样式
    lv_obj_set_style_radius(obj[i], 0, 0);                     // 设置圆角
    lv_obj_set_style_pad_all(obj[i], 4, 0);                    // 设置边距
    lv_obj_set_style_text_color(obj[i], MY_COLOR_BLACK, LV_STATE_DEFAULT);
    // 标签
    label_share[i] = lv_label_create(obj[i]); // X
    lv_obj_align(label_share[i], LV_ALIGN_LEFT_MID, -3, 0);
    lv_obj_set_style_text_font(label_share[i], &MiSans_Bold_16px, 0);
  }

  // 底部模式提示 对象
  lv_obj_t *bottom_bg= lv_obj_create(page.p[page.index]);
  lv_obj_set_size(bottom_bg, 74, 20);
  lv_obj_align(bottom_bg, LV_ALIGN_BOTTOM_MID, 0, 0);
  lv_obj_set_style_bg_color(bottom_bg, MY_COLOR_BLACK, 0);
  lv_obj_set_scrollbar_mode(bottom_bg, LV_SCROLLBAR_MODE_OFF); // 关闭滑动条
  lv_obj_add_style(bottom_bg, &style_shadow, 0);               // 添加阴影不透明度样式
  lv_obj_add_style(bottom_bg, &style_squareShape, 0);          // 添加方形样式
  // 底部模式提示 标签
  lv_obj_t *bottom_label = lv_label_create(bottom_bg);
  lv_obj_align(bottom_label, LV_ALIGN_CENTER, 0, 0);
  lv_obj_set_style_text_color(bottom_label, MY_COLOR_WHITE, LV_STATE_DEFAULT);
  String text;
  if      (eep_accDispMod == 0) text = F("原始");
  else if (eep_accDispMod == 1) text = F("原始滤波");
  else if (eep_accDispMod == 2) text = F("角度原始");
  else if (eep_accDispMod == 3) text = F("角度调零");
  lv_label_set_text(bottom_label, text.c_str());

  // 创建定时器并保存句柄
  lvTimer_share[0] = lv_timer_create(updateAcc_timer_cb, 100, NULL); // 定时更新

  //int32_t num = lv_obj_get_child_count(page2);
  //LV_LOG_USER("page2对象数量:%u", num);
}

//****** 时钟界面
void updateClock_timer_cb(lv_timer_t *time) // 定时更新时钟数据
{
  if (eep_disPage != page_clock)
  {
    bitWrite(backgroundTask, BGT_CLOCK_READ, 0); // 标记关闭
    return;
  }

  // 秒标签已删除，返回
  if (label_timeSecond == NULL) return;
  // 打开了备忘录功能并且有句子，返回
  //if (eep_memoClockEn && eep_inAWord.length() > 1 && ((RTC_clock_count & 1) == 0)) return;

  String hour = String(curTime.hour);
  String minute = String(curTime.minute);
  if (curTime.hour <= 9) hour = "0" + String(curTime.hour);
  if (curTime.minute <= 9) minute = "0" + String(curTime.minute);
  lv_label_set_text_fmt(label_timeHour, "%s", hour);
  lv_label_set_text_fmt(label_timeMinute, "%s", minute);
  lv_label_set_text_fmt(label_timeSecond, "%d", curTime.second);
  lv_label_set_text_fmt(label_temp, "%.0f℃", cpuTemp);

  // 更新电池绿色内容
#if FUEL_GAUGE_TYPE == 0
  bat_soc = batVccToPer(bat_vcc);
#else
  get_bat_soc();
#endif 

  uint8_t w = map(bat_soc, 0, 100, 3, 21);
  lv_obj_set_size(bat_g, w, 9);
  //更新电量
  if (bat_soc >= 10.0) lv_label_set_text_fmt(label_batPer, "%d%%", (uint8_t)bat_soc);
  else               lv_label_set_text_fmt(label_batPer, "%.1f%%", bat_soc);
  if (bat_soc > 60) // 大于60显示绿色
    lv_obj_set_style_bg_color(bat_g, MY_COLOR_GREEN, LV_STATE_DEFAULT);   // 背景颜色
  else if (bat_soc > 30) // 大于30显示洋红
    lv_obj_set_style_bg_color(bat_g, MY_COLOR_MAGENTA, LV_STATE_DEFAULT); // 背景颜色
  else // 小于等于30显示红色
    lv_obj_set_style_bg_color(bat_g, MY_COLOR_RED, LV_STATE_DEFAULT);     // 背景颜色
}
//定时器回调 永久休眠
void sleep_zero_time_cb(lv_timer_t *a) // 播放完低电图片后永久休眠的回调
{
  esp_sleep(0);
}
//定时器回调 时钟界面定时器休眠策略
void clockTimedWakeUp_time_cb(lv_timer_t *t) // 定时唤醒的事件回调的定时器回调
{
  // 播放低电量图片
  if (bat_vcc < BAT_LOW2) // BAT_LOW2
  {
    // 自定义图片打开成功
    if (eep_batSleepPicEn && eep_batSleepPic.length() > 1)
    {
      File file = LittleFS.open(eep_batSleepPic);
      if (file)
      {
        display_picture_init(eep_batSleepPic, 0);
        lv_screen_load_anim(page.p[page.index], LV_SCR_LOAD_ANIM_FADE_IN, GRADUAL_ANIM_TIME, 0, true);
        eep_doudong = 1;
      }
      file.close();
    }

    // 创建一个单次定时器,3秒后让系统永久休眠
    lv_timer_t *timer = lv_timer_create(sleep_zero_time_cb, 3000, NULL); // 3秒后打开
    lv_timer_set_repeat_count(timer, 1);
    lv_timer_set_auto_delete(timer, true);
  }
  else // 正常休眠
  { 
    clock_read();
    sleepTime = 60000 - (curTime.second * 1000);
    if (sleepTime <= 0) sleepTime = 100;
    if (eep_clockSleepOffScreen) sleepTime = 0; // 时钟界面息屏打开不再定时唤醒
    esp_sleep(sleepTime);
  }
}
void clockSleep_event_cb(lv_event_t *e) // 定时唤醒的事件回调
{
  // 创建一个单次定时器
  lv_timer_t *timer = lv_timer_create(clockTimedWakeUp_time_cb, 50, NULL); // 0.05秒后打开
  lv_timer_set_repeat_count(timer, 1);
  lv_timer_set_auto_delete(timer, true);
}
void display_clock_event(lv_event_t *e)
{
  //lv_event_code_t code = lv_event_get_code(e);
  //lv_obj_t *obj = lv_event_get_target_obj(e);
  uint8_t key = lv_indev_get_key(lv_indev_active());
  if (key == LV_KEY_RIGHT)
  {
    // 删除时钟数据更新定时器
    if (lvTimer_share[0] != NULL)
    {
      lv_timer_delete(lvTimer_share[0]);
      lvTimer_share[0] = NULL;
    }
    // 关闭时钟读取任务
    bitWrite(backgroundTask, BGT_CLOCK_READ, 0);
    display_acc_init(); //切换至加速度界面界面
    lv_screen_load_anim(page.p[page.index], LV_SCR_LOAD_ANIM_MOVE_TOP, PAGE_SWITCH_ANIM_TIME, 0, true);
    bitWrite(backgroundTask, BGT_ACC_READ, 1); // 打开加速度读取任务
  }
}
void display_clock_init()
{
  eepSavePage(page_clock);

  LV_FONT_DECLARE(rog_38px);
  LV_FONT_DECLARE(MiSans_Bold_14px);
  LV_FONT_DECLARE(ArialRoundedMTBold_14px);
  LV_FONT_DECLARE(DinkieBitmap_10px);
  
  clock_read();
  uint8_t index = pageInit(KEY_MODE_RL, FIRST_EVENT_OFF);
  page.p[index] = lv_obj_create(NULL);
  lv_obj_set_size(page.p[index], TFT_HOR_RES, TFT_VER_RES);
  lv_obj_align(page.p[index], LV_ALIGN_CENTER, 0, 0);
  lv_obj_set_scrollbar_mode(page.p[index], LV_SCROLLBAR_MODE_OFF);             // 关闭滑动条
  lv_obj_add_style(page.p[index], &style_squareShape, 0);                      // 添加正方形样式
  lv_group_add_obj(group_my, page.p[index]);                                   // 将对象邦定到组
  lv_obj_add_event_cb(page.p[index], display_clock_event, LV_EVENT_KEY, NULL); // 设置回调

  //****************** 时钟的背景 ******************
  lv_obj_t *clock_bg = lv_obj_create(page.p[index]);
  lv_obj_set_scrollbar_mode(clock_bg, LV_SCROLLBAR_MODE_OFF); // 关闭滑动条
  lv_obj_set_size(clock_bg, 72, 79);
  // lv_obj_set_style_bg_color(clock_bg, MY_COLOR_WHITE, LV_STATE_DEFAULT);
  lv_obj_set_style_pad_all(clock_bg, 0, LV_STATE_DEFAULT);                  // 设置边距
  lv_obj_set_style_radius(clock_bg, 0, LV_STATE_DEFAULT);                   // 设置圆角
  lv_obj_set_style_border_color(clock_bg, MY_COLOR_CYAN, LV_STATE_DEFAULT); // 边框颜色
  lv_obj_set_style_border_width(clock_bg, 2, LV_STATE_DEFAULT);             // 边框宽度
  lv_obj_align(clock_bg, LV_ALIGN_TOP_MID, 0, 0);
  // 画时间
  label_timeHour = lv_label_create(clock_bg); // 小时
  lv_obj_set_style_pad_all(label_timeHour, 0, LV_STATE_DEFAULT); //设置边距
  lv_obj_align(label_timeHour, LV_ALIGN_TOP_MID, 0, 5);
  String hour = String(curTime.hour);
  String minute = String(curTime.minute);
  if (curTime.hour <= 9) hour = "0" + String(curTime.hour);
  if (curTime.minute <= 9) minute = "0" + String(curTime.minute);
  lv_label_set_text_fmt(label_timeHour, "%s", hour);
  lv_obj_set_style_text_color(label_timeHour, MY_COLOR_BLACK, LV_STATE_DEFAULT);//字体颜色
  lv_obj_set_style_text_font(label_timeHour, &rog_38px, LV_STATE_DEFAULT);

  label_timeMinute = lv_label_create(clock_bg); // 分钟
  lv_obj_set_style_pad_all(label_timeMinute, 0, LV_STATE_DEFAULT); //设置边距
  lv_obj_align(label_timeMinute, LV_ALIGN_TOP_MID, 0, 42);
  lv_label_set_text_fmt(label_timeMinute, "%s", minute);
  lv_obj_set_style_text_color(label_timeMinute, MY_COLOR_BLACK, LV_STATE_DEFAULT);//字体颜色
  lv_obj_set_style_text_font(label_timeMinute, &rog_38px, LV_STATE_DEFAULT);

  if (RTC_timedWakeUp == 0) // 非定时唤醒
  {
    label_timeSecond = lv_label_create(clock_bg);                    // 秒
    lv_obj_set_style_pad_all(label_timeSecond, 1, LV_STATE_DEFAULT); // 设置边距
    lv_obj_align(label_timeSecond, LV_ALIGN_RIGHT_MID, 1, 34);
    lv_label_set_text_fmt(label_timeSecond, "%d", curTime.second);
    lv_obj_set_style_text_color(label_timeSecond, MY_COLOR_RED, LV_STATE_DEFAULT); // 字体颜色
    lv_obj_set_style_text_font(label_timeSecond, &DinkieBitmap_10px, LV_STATE_DEFAULT);
    // lv_obj_set_style_bg_color(label_timeSecond, MY_COLOR_GREEN, LV_STATE_DEFAULT);
    // lv_obj_set_style_bg_opa(label_timeSecond, LV_OPA_100, LV_STATE_DEFAULT);
  }
  //****************** 日期背景 ****************** 
  lv_obj_t *date_bg = lv_obj_create(page.p[index]);
  lv_obj_set_scrollbar_mode(date_bg, LV_SCROLLBAR_MODE_OFF); // 关闭滑动条
  lv_obj_add_style(date_bg, &style_squareShape, 0);
  lv_obj_set_style_bg_color(date_bg, MY_COLOR_CYAN, LV_STATE_DEFAULT);
  lv_obj_set_size(date_bg, 72, 19);
  lv_obj_set_pos(date_bg, 0, 78);
  
  // 月日星期
  String date = String(curTime.month) + "-" + String(curTime.dayOfMonth) + " 周";
  date += weekDigitalToChinese(curTime.dayOfWeek);
  label_timeDate = lv_label_create(date_bg); // 月日星期
  lv_obj_set_style_pad_all(label_timeDate, 0, LV_STATE_DEFAULT); // 设置边距
  lv_obj_align(label_timeDate, LV_ALIGN_CENTER, 0, 1);
  lv_label_set_text_fmt(label_timeDate, "%s", date);
  lv_obj_set_style_text_color(label_timeDate, MY_COLOR_BLACK, LV_STATE_DEFAULT);// 字体颜色
  lv_obj_set_style_text_font(label_timeDate, &MiSans_Bold_14px, LV_STATE_DEFAULT);

  //****************** 温度的背景 ****************** 
  lv_obj_t *temp_bg = lv_obj_create(page.p[index]);
  lv_obj_set_scrollbar_mode(temp_bg, LV_SCROLLBAR_MODE_OFF); // 关闭滑动条
  lv_obj_add_style(temp_bg, &style_squareShape, 0);
  lv_obj_set_size(temp_bg, 72, 20);
  lv_obj_set_pos(temp_bg, 0, 101);
  lv_obj_set_style_bg_color(temp_bg, MY_COLOR_BLUE, LV_STATE_DEFAULT);
  label_temp = lv_label_create(temp_bg); // cpu温度
  lv_obj_set_style_pad_all(label_temp, 0, LV_STATE_DEFAULT); //设置边距
  lv_obj_align(label_temp, LV_ALIGN_LEFT_MID, 6, 0);
  lv_label_set_text_fmt(label_temp, "%.0f℃", cpuTemp);
  lv_obj_set_style_text_color(label_temp, MY_COLOR_WHITE, LV_STATE_DEFAULT);//字体颜色
  lv_obj_set_style_text_font(label_temp, &MiSans_Bold_14px, LV_STATE_DEFAULT);
  //****** 画cpu图标
  /*lv_point_precise_t *line_points = my_draw_rectangle(58, 110, 7, 7);
  lv_obj_t *line1 = lv_line_create(page.p[index]);
  lv_line_set_points(line1, line_points, 5);                            // 点数量
  lv_obj_set_style_line_width(line1, 1, LV_STATE_DEFAULT);              // 线宽度
  lv_obj_set_style_line_color(line1, MY_COLOR_WHITE, LV_STATE_DEFAULT); // 线颜色
  lv_obj_set_style_line_rounded(line1, true, LV_STATE_DEFAULT);         // 线圆角
  */
  LV_IMAGE_DECLARE(img_cpu);
  lv_obj_t *img1 = lv_image_create(temp_bg);
  lv_image_set_src(img1, &img_cpu);
  lv_obj_align(img1, LV_ALIGN_RIGHT_MID, -6, 0);

  //****************** 电量背景 ******************
  lv_obj_t *power_bg = lv_obj_create(page.p[index]);
  lv_obj_set_scrollbar_mode(power_bg, LV_SCROLLBAR_MODE_OFF); // 关闭滑动条
  lv_obj_set_style_bg_color(power_bg, MY_COLOR_BLACK, LV_STATE_DEFAULT);
  lv_obj_add_style(power_bg, &style_squareShape, 0);
  lv_obj_set_size(power_bg, 72, 19);
  lv_obj_align(power_bg, LV_ALIGN_BOTTOM_MID, 0, 0);
  // 画电池的白色外框
  lv_obj_t *bat = lv_obj_create(power_bg);
  lv_obj_set_size(bat, 25, 13);
  lv_obj_set_style_bg_color(bat, MY_COLOR_WHITE, LV_STATE_DEFAULT); // 背景颜色
  lv_obj_set_style_pad_all(bat, 0, LV_STATE_DEFAULT);               // 设置边距
  lv_obj_set_style_radius(bat, 2, LV_STATE_DEFAULT);                // 设置圆角
  lv_obj_set_style_border_width(bat, 0, LV_STATE_DEFAULT);          // 边框宽度
  lv_obj_align(bat, LV_ALIGN_LEFT_MID, 3, 0);
  // 画电池的绿色内容
  bat_g = lv_obj_create(bat);

#if FUEL_GAUGE_TYPE == 0
  bat_soc = batVccToPer(bat_vcc);
#else
  get_bat_soc();
#endif

  uint8_t w = map(bat_soc, 0, 100, 3, 21);
  lv_obj_set_size(bat_g, w, 9);
  if (bat_soc > 60) // 大于60显示绿色
    lv_obj_set_style_bg_color(bat_g, MY_COLOR_GREEN, LV_STATE_DEFAULT);   // 背景颜色
  else if (bat_soc > 30) // 大于30显示洋红
    lv_obj_set_style_bg_color(bat_g, MY_COLOR_MAGENTA, LV_STATE_DEFAULT); // 背景颜色
  else // 小于等于30显示红色
    lv_obj_set_style_bg_color(bat_g, MY_COLOR_RED, LV_STATE_DEFAULT);     // 背景颜色

  lv_obj_set_style_pad_all(bat_g, 0, LV_STATE_DEFAULT);               // 设置边距
  lv_obj_set_style_radius(bat_g, 1, LV_STATE_DEFAULT);                // 设置圆角
  lv_obj_set_style_border_width(bat_g, 0, LV_STATE_DEFAULT);          // 边框宽度
  lv_obj_align(bat_g, LV_ALIGN_LEFT_MID, 2, 0);
  // 画电池的白色头
  lv_obj_t *bat_w = lv_obj_create(power_bg);
  lv_obj_set_size(bat_w, 2, 9);
  lv_obj_set_style_bg_color(bat_w, MY_COLOR_WHITE, LV_STATE_DEFAULT); // 背景颜色
  lv_obj_set_style_pad_all(bat_w, 0, LV_STATE_DEFAULT);               // 设置边距
  lv_obj_set_style_radius(bat_w, 1, LV_STATE_DEFAULT);                // 设置圆角
  lv_obj_set_style_border_width(bat_w, 0, LV_STATE_DEFAULT);          // 边框宽度
  lv_obj_align_to(bat_w, bat, LV_ALIGN_OUT_RIGHT_MID, 2, 0);
  // 画电量百分比
  label_batPer = lv_label_create(power_bg);
  lv_obj_align(label_batPer, LV_ALIGN_RIGHT_MID, -1, 1);
  if (bat_soc >= 10.0) lv_label_set_text_fmt(label_batPer, "%d%%", (uint8_t)bat_soc);
  else                 lv_label_set_text_fmt(label_batPer, "%.1f%%", bat_soc);
  lv_obj_set_style_text_color(label_batPer, MY_COLOR_WHITE, LV_STATE_DEFAULT); // 字体颜色
  lv_obj_set_style_text_font(label_batPer, &ArialRoundedMTBold_14px, LV_STATE_DEFAULT);

  //******** 添加自定义的句子
  if (eep_memoClockEn && eep_inAWord.length() > 1 && ((RTC_clock_count & 1) == 0)) // 偶数
  {
    lv_color_t color[8] = {MY_COLOR_CYAN, MY_COLOR_GREEN, MY_COLOR_YELLOW, MY_COLOR_MAGENTA,
                           MY_COLOR_BLUE, MY_COLOR_RED, MY_COLOR_WHITE, MY_COLOR_BLACK};

    //****************** 一句话
    lv_obj_t *sentence_bg = lv_obj_create(page.p[index]); //背景
    lv_obj_add_style(sentence_bg, &style_squareShape, 0);          // 添加正方形样式
    lv_obj_set_scrollbar_mode(sentence_bg, LV_SCROLLBAR_MODE_OFF); // 关闭滑动条
    lv_obj_add_style(sentence_bg, &style_squareShape, 0); 
    lv_obj_set_style_bg_color(sentence_bg, color[eep_memoBg], LV_STATE_DEFAULT);
    lv_obj_set_pos(sentence_bg, 0, 97);
    lv_obj_set_size(sentence_bg, 72, 47);

    const char *inAWord = eep_inAWord.c_str();
    lv_obj_t *sentence = lv_label_create(sentence_bg); // 句子
    lv_obj_add_style(sentence, &style_squareShape, 0); // 添加正方形样式
    const lv_font_t *font = lv_obj_get_style_text_font(sentence, 0);
    // 对长字符分行时，缩短其间隔
    uint8_t line = 1;
    String result = autoLineFeed(inAWord, 72, font, &line); // 自动根据指定像素值添加换行符
    //Serial.printf("line:%d\n", line);
    lv_obj_align(sentence, LV_ALIGN_CENTER, 0, 1);
    lv_label_set_text(sentence, result.c_str());
    lv_obj_set_style_text_color(sentence, color[eep_memoFC], 0); // 字体颜色
    if (line >= 4)
      lv_obj_align(sentence, LV_ALIGN_TOP_MID, 0, -2);
    if (line >= 3)                                       // 三行以上时缩短行间距
      lv_obj_set_style_text_line_space(sentence, -4, 0); // 设置行间距
  }

  //******** 创建定时器并保存句柄
  if (RTC_timedWakeUp == 0) // 非定时唤醒
  {
    lvTimer_share[0] = lv_timer_create(updateClock_timer_cb, 1000, NULL); // 定时更新
  }
  else // 定时唤醒
  {
    lv_obj_add_event_cb(page.p[index], clockSleep_event_cb, LV_EVENT_SCREEN_LOADED, NULL);
  }
}

//****** 退出至时钟设置界面
void backPage_clockSet(lv_event_t *e) 
{
  uint8_t *data = (uint8_t *)lv_event_get_user_data(e);
  if (data[0] == 0) // 退出
  {
   my_msgbox_exit(10); // 退出弹窗
    display_clockSet_init();
    lv_screen_load_anim(page.p[page.index], LV_SCR_LOAD_ANIM_FADE_OUT, GRADUAL_ANIM_TIME, 0, true);
    onGlobalJitter();     // 打开全局抖动
    focusPosOld_return(); // 回到刚才的焦点
  }
  else if (data[0] == 1) // 返回
  {
   my_msgbox_exit(0); // 退出弹窗
    }
}
//****** 时钟手动校准界面
void clockManualCal_end_cb(lv_event_t *e) // 弹窗退出保存返回
{
  uint8_t *data = (uint8_t *)lv_event_get_user_data(e);
  if (data[0] == 0 || data[0] == 1) // 退出手动校准界面 || 保存
  {
   my_msgbox_exit(10); // 退出弹窗
    display_clockSet_init();
    lv_screen_load_anim(page.p[page.index], LV_SCR_LOAD_ANIM_FADE_OUT, GRADUAL_ANIM_TIME, 0, true);
    onGlobalJitter();     // 打开全局抖动
    focusPosOld_return(); // 回到刚才的焦点
    if (data[0] == 1)
    {
      adapter.writeDateTime(sdjzTime);          // 写入芯片
    }
  }
  else if (data[0] == 2) // 返回手动校准界面
  {
   my_msgbox_exit(0); // 退出弹窗
  }
}
void clockManualCal_event0(lv_event_t *e) // 退出弹窗
{
    my_msgbox_send(F("手动校准"), F("是否退出"), 0, F("退出\n保存\n返回\n"), clockManualCal_end_cb);
}
void clockManualCal_event1(lv_event_t *e) // 切换标签编辑模式的事件 
{
  lv_event_code_t code = lv_event_get_code(e);
  lv_obj_t *obj = lv_event_get_target_obj(e);
  lv_obj_t *child = lv_obj_get_child(obj, 0);
  uint8_t *data = (uint8_t *)lv_event_get_user_data(e);
  uint8_t i = data[0];
  //Serial.printf("code:%d\n",code);

  if (code == LV_EVENT_PRESSED) // 切换编辑状态
  {
    bool run = addAnimation_event(obj, button_width_shrink_anim_init); // 添加动画不重叠
    if(run == 1) return;
    if (page.keyMode == KEY_MODE_PN) // 进入编辑模式，修改成白底黑字
    {
      page.keyMode = KEY_MODE_RL;
      lv_obj_set_style_bg_color(obj, MY_COLOR_BLACK, LV_STATE_DEFAULT); // 设置背景颜色
      lv_obj_set_style_text_color(child, MY_COLOR_WHITE, LV_STATE_DEFAULT);
    }
    else  // 取消编辑模式，恢复原来的样式
    {
      page.keyMode = KEY_MODE_PN;
      lv_color_t color[6] = {MY_COLOR_CYAN, MY_COLOR_GREEN, MY_COLOR_YELLOW,
                             MY_COLOR_MAGENTA, MY_COLOR_BLUE, MY_COLOR_RED};
      lv_obj_set_style_bg_color(obj, color[i % 6], LV_STATE_DEFAULT); // 设置背景颜色
      if ((i % 6) < 3)
        lv_obj_set_style_text_color(child, MY_COLOR_BLACK, LV_STATE_DEFAULT);
      else
        lv_obj_set_style_text_color(child, MY_COLOR_WHITE, LV_STATE_DEFAULT);
    }
  }
  else if(code == LV_EVENT_KEY)  // 数值加减
  {
    uint8_t key = lv_indev_get_key(lv_indev_active());
    if (key == LV_KEY_ENTER) return;

    bool run = addAnimation_event(obj, button_width_shrink_anim_init); // 添加动画不重叠
    if(run == 1) return;  

    // 数值加减
    if (key == LV_KEY_LEFT) // 减
    {
      if (*sm0.num_u8[i] == sm0.min[i])
        *sm0.num_u8[i] = sm0.max[i];
      else
        *sm0.num_u8[i] -= sm0.step[i];
    }
    else if (key == LV_KEY_RIGHT) // 加
    {
      if (*sm0.num_u8[i] == sm0.max[i])
        *sm0.num_u8[i] = sm0.min[i];
      else
        *sm0.num_u8[i] += sm0.step[i];
    }

    String text = String(lv_label_get_text(child));
    int pos = text.indexOf("：");
    text = text.substring(0, pos + 3);
    text += String(*sm0.num_u8[i]);
    // Serial.printf("text:%s", text);
    lv_label_set_text(child, text.c_str()); // 标签文本
  }

  LV_UNUSED(obj);
  LV_UNUSED(child);
}
void display_clockManualCal_init()
{
  eepSavePage(page_clockManualCal, 0);

  uint8_t j = 0;
  sm0.num_u8[j++] = &sdjzTime.year;       // 年
  sm0.num_u8[j++] = &sdjzTime.month;      // 月
  sm0.num_u8[j++] = &sdjzTime.dayOfMonth; // 日
  sm0.num_u8[j++] = &sdjzTime.hour;       // 时
  sm0.num_u8[j++] = &sdjzTime.minute;     // 分
  sm0.num_u8[j++] = &sdjzTime.second;     // 秒
  sm0.num_u8[j++] = &sdjzTime.dayOfWeek;  // 星期 0=星期天
  j = 0;
  sm0.step[j++] = 1; // 加减的步进值
  sm0.step[j++] = 1; 
  sm0.step[j++] = 1; 
  sm0.step[j++] = 1; 
  sm0.step[j++] = 1; 
  sm0.step[j++] = 1; 
  sm0.step[j++] = 1; 
  j = 0;
  sm0.min[j++] = 0;  // 最小值
  sm0.min[j++] = 1; 
  sm0.min[j++] = 1; 
  sm0.min[j++] = 0; 
  sm0.min[j++] = 0;
  sm0.min[j++] = 0; 
  sm0.min[j++] = 0; 
  j = 0;
  sm0.max[j++] = 99;  // 最大值
  sm0.max[j++] = 12; 
  sm0.max[j++] = 31; 
  sm0.max[j++] = 23;
  sm0.max[j++] = 59;
  sm0.max[j++] = 59;
  sm0.max[j++] = 6;

  uint8_t index = pageInit(KEY_MODE_PN, FIRST_EVENT_ON);
  page.p[index] = lv_obj_create(NULL);
  lv_obj_set_scrollbar_mode(page.p[index], LV_SCROLLBAR_MODE_OFF);       // 关闭滑动条
  lv_obj_add_style(page.p[index], &style_shadow, LV_STATE_DEFAULT);      // 添加阴影不透明度样式
  lv_obj_add_style(page.p[index], &style_squareShape, LV_STATE_DEFAULT); // 添加方形样式
  lv_obj_set_style_pad_top(page.p[index], 3, LV_STATE_DEFAULT);
  lv_obj_set_style_pad_bottom(page.p[index], 3, LV_STATE_DEFAULT);

  String obj_name[7];
  uint8_t count = 0;
  if (eep_language == 0)
  {
    obj_name[count++] = F("年：%d");
    obj_name[count++] = F("月：%d");
    obj_name[count++] = F("日：%d");
    obj_name[count++] = F("时：%d");
    obj_name[count++] = F("分：%d");
    obj_name[count++] = F("秒：%d");
    obj_name[count++] = F("星期：%d");
  }
  else
  {
    obj_name[count++] = F("Year：%d");
    obj_name[count++] = F("Month：%d");
    obj_name[count++] = F("Day：%d");
    obj_name[count++] = F("Hour：%d");
    obj_name[count++] = F("Minute：%d");
    obj_name[count++] = F("Second：%d");
    obj_name[count++] = F("Week：%d");
  }
  
  lv_obj_t *but[7];
  lv_obj_t *label[7];

  lv_color_t color[6] = {MY_COLOR_CYAN, MY_COLOR_GREEN, MY_COLOR_YELLOW,
                         MY_COLOR_MAGENTA, MY_COLOR_BLUE, MY_COLOR_RED};

  if (sdjzTime.dayOfWeek == 0) sdjzTime.dayOfWeek = 7;

  uint16_t timeArray[7];
  for (uint8_t i = 0; i < 7; i++)
    timeArray[i] = *sm0.num_u8[i];

  for (uint8_t i = 0; i < 7; i++)
  {
    // 按钮对象
    but[i] = lv_button_create(page.p[index]);
    lv_obj_set_size(but[i], 72, 20);                                            // 设置大小
    lv_obj_align(but[i], LV_ALIGN_TOP_MID, 0, i * 24);                          // 设置对齐方式
    lv_obj_set_style_bg_color(but[i], color[i % 6], LV_STATE_DEFAULT);          // 设置背景颜色
    lv_obj_add_style(but[i], &style_shadow, LV_STATE_DEFAULT);                  // 设置阴影样式
    lv_obj_add_style(but[i], &style_squareShape, LV_STATE_DEFAULT);             // 设置方型样式
    lv_obj_set_style_outline_width(but[i], 2, LV_STATE_FOCUS_KEY);              // 聚焦框的宽度
    lv_obj_set_style_outline_pad(but[i], 0, LV_STATE_FOCUS_KEY);                // 聚焦框的间隙
    lv_obj_set_style_outline_opa(but[i], LV_OPA_100, LV_STATE_FOCUS_KEY);       // 聚焦框的不透明度
    lv_obj_set_style_outline_width(but[i], 0, LV_STATE_DEFAULT);                // 失焦时的宽度
    lv_obj_set_style_outline_color(but[i], MY_COLOR_BLACK, LV_STATE_FOCUS_KEY); // 聚焦框颜色
    lv_obj_set_scrollbar_mode(but[i], LV_SCROLLBAR_MODE_OFF);                   // 关闭滑动条
    // 标签对象
    label[i] = lv_label_create(but[i]);                                 // 创建标签
    lv_obj_align(label[i], LV_ALIGN_LEFT_MID, 6, 0);                    // 居中对齐
    lv_label_set_text_fmt(label[i], obj_name[i].c_str(), timeArray[i]); // 标签文本
    if ((i % 6) < 3)
      lv_obj_set_style_text_color(label[i], MY_COLOR_BLACK, LV_STATE_DEFAULT);
    else
      lv_obj_set_style_text_color(label[i], MY_COLOR_WHITE, LV_STATE_DEFAULT);
    // 将对象邦定到组
    lv_group_add_obj(group_my, but[i]);
    // 添加按钮聚焦动画
    lv_obj_add_event_cb(but[i], buttonFocus_anim_event, LV_EVENT_FOCUSED, NULL);

    // 按钮触发功能
    lv_obj_add_event_cb(but[i], clockManualCal_event1, LV_EVENT_PRESSED, &num[i]); // 切换编辑状态
    lv_obj_add_event_cb(but[i], clockManualCal_event1, LV_EVENT_KEY, &num[i]);     // 编辑状态下的数值加减
  }

  lv_obj_t *but_exit = lv_button_create(page.p[page.index]);
  lv_obj_set_size(but_exit, 72, 25);                                            // 设置大小
  lv_obj_align(but_exit, LV_ALIGN_TOP_MID, 0, 7 * 24);                          // 设置对齐方式
  lv_obj_set_style_bg_color(but_exit, MY_COLOR_GREEN, LV_STATE_DEFAULT);        // 设置背景颜色
  lv_obj_add_style(but_exit, &style_shadow, LV_STATE_DEFAULT);                  // 设置阴影样式
  lv_obj_add_style(but_exit, &style_squareShape, LV_STATE_DEFAULT);             // 设置方型样式
  lv_obj_set_style_outline_width(but_exit, 2, LV_STATE_FOCUS_KEY);              // 聚焦框的宽度
  lv_obj_set_style_outline_pad(but_exit, 0, LV_STATE_FOCUS_KEY);                // 聚焦框的间隙
  lv_obj_set_style_outline_opa(but_exit, LV_OPA_100, LV_STATE_FOCUS_KEY);       // 聚焦框的不透明度
  lv_obj_set_style_outline_width(but_exit, 0, LV_STATE_DEFAULT);                // 失焦时的宽度
  lv_obj_set_style_outline_color(but_exit, MY_COLOR_BLACK, LV_STATE_FOCUS_KEY); // 聚焦框颜色
  lv_obj_set_scrollbar_mode(but_exit, LV_SCROLLBAR_MODE_OFF);                   // 关闭滑动条
  lv_obj_t *label_exit = lv_label_create(but_exit);                             // 创建标签
  lv_obj_align(label_exit, LV_ALIGN_CENTER, 0, 0);                              // 对齐方式
  lv_label_set_text(label_exit, "退出");                                        // 标签文本
  if ((7 % 6) < 3)
    lv_obj_set_style_text_color(label_exit, MY_COLOR_BLACK, LV_STATE_DEFAULT);
  else
    lv_obj_set_style_text_color(label_exit, MY_COLOR_WHITE, LV_STATE_DEFAULT);

  lv_obj_add_event_cb(but_exit, clockManualCal_event0, LV_EVENT_PRESSED, NULL);  // 退出回调
  lv_obj_add_event_cb(but_exit, buttonFocus_anim_event, LV_EVENT_FOCUSED, NULL); // 添加聚焦动画
  lv_obj_add_event_cb(but_exit, buttonFocus_anim_event2, LV_EVENT_FOCUSED, NULL);

  lv_group_add_obj(group_my, but_exit);

  // 将对象邦定到组
  //lv_group_add_obj(group_my, page.p[index]);
  // 聚焦触发 弹出退出返回框
  //lv_obj_add_event_cb(page.p[index], display_clockManualCal_event0, LV_EVENT_FOCUSED, NULL);
}
//****** 时钟设置界面
void clockSet_event(lv_event_t *e) // 跳转事件
{
  uint8_t *data = (uint8_t *)lv_event_get_user_data(e);
  uint8_t i = data[0];
  //Serial.printf("跳转事件:%d\n", i);

  if (i == 0) // 手动校准
  {
    clock_read();
    sdjzTime = curTime;
    focusPosOld_save(); // 保存上一个界面的焦点
    display_clockManualCal_init();
    lv_screen_load_anim(page.p[page.index], LV_SCR_LOAD_ANIM_FADE_IN, GRADUAL_ANIM_TIME, 0, true);
    onGlobalJitter(); // 打开全局抖动
  }
  else if (i == 1) // 联网校准
  {
    bitWrite(backgroundTask, BGT_CLOCK_AUTU_CALI, 1);
  }
  else if (i == 2) // 卫星校准
  {
    my_msgbox_send(F("卫星校准"), F("未完成"), 1000);
  }
}
void display_clockSet_init()
{
  eepSavePage(page_clockSet, 0);

  pageInit(KEY_MODE_PN, FIRST_EVENT_OFF);
  page.p[page.index] = lv_obj_create(NULL);
  lv_obj_set_scrollbar_mode(page.p[page.index], LV_SCROLLBAR_MODE_OFF);       // 关闭滑动条
  lv_obj_add_style(page.p[page.index], &style_shadow, LV_STATE_DEFAULT);      // 添加阴影不透明度样式
  lv_obj_add_style(page.p[page.index], &style_squareShape, LV_STATE_DEFAULT); // 添加方形样式
  lv_obj_set_style_pad_top(page.p[page.index], 4, LV_STATE_DEFAULT);
  lv_obj_set_style_pad_bottom(page.p[page.index], 3, LV_STATE_DEFAULT);

  lv_obj_set_flex_flow(page.p[page.index], LV_FLEX_FLOW_COLUMN);
  // 参数2：将项目放置在主轴上的位置（在其轨迹中）。lv_flex_align_t的任何值 控制Y轴排布
  // 参数3：在横轴上的轨迹中放置项目的位置。LV_FLEX_ALIGN_START/END/CENTER
  // 参数4：在交叉方向上放置轨道的位置。lv_flex_align_t的任何值。 控制X轴排布
  lv_obj_set_flex_align(page.p[page.index], LV_FLEX_ALIGN_START, LV_FLEX_ALIGN_CENTER, LV_FLEX_ALIGN_CENTER);
  // lv_obj_set_flex_grow(page.p[page.index], 3); //设置对象生长的宽度或高度（在主轴上），以填充自由空间
  lv_obj_set_style_pad_row(page.p[page.index], 5, LV_STATE_DEFAULT); // 设置行间距为5像素

  uint8_t optNum = 3;
  String obj_name[optNum] = {F("手动校准"), F("联网校准"), F("卫星校准")};
  lv_obj_t *but[optNum];
  lv_obj_t *label[optNum];
  lv_color_t color[6] = {MY_COLOR_CYAN, MY_COLOR_GREEN, MY_COLOR_YELLOW,
                         MY_COLOR_MAGENTA, MY_COLOR_BLUE, MY_COLOR_RED};
  for (uint8_t i = 0; i < optNum; i++)
  {
    // 按钮对象
    but[i] = lv_button_create(page.p[page.index]);
    lv_obj_set_size(but[i], 72, 25);                                            // 设置大小
    //lv_obj_align(but[i], LV_ALIGN_TOP_MID, 0, i * 46);                          // 设置对齐方式
    lv_obj_set_style_bg_color(but[i], color[i % 6], LV_STATE_DEFAULT);          // 设置背景颜色
    lv_obj_add_style(but[i], &style_shadow, LV_STATE_DEFAULT);                  // 设置阴影样式
    lv_obj_add_style(but[i], &style_squareShape, LV_STATE_DEFAULT);             // 设置方型样式
    lv_obj_set_style_outline_width(but[i], 2, LV_STATE_FOCUS_KEY);              // 聚焦框的宽度
    lv_obj_set_style_outline_pad(but[i], 0, LV_STATE_FOCUS_KEY);                // 聚焦框的间隙
    lv_obj_set_style_outline_opa(but[i], LV_OPA_100, LV_STATE_FOCUS_KEY);       // 聚焦框的不透明度
    lv_obj_set_style_outline_width(but[i], 0, LV_STATE_DEFAULT);                // 失焦时的宽度
    lv_obj_set_style_outline_color(but[i], MY_COLOR_BLACK, LV_STATE_FOCUS_KEY); // 聚焦框颜色
    lv_obj_set_scrollbar_mode(but[i], LV_SCROLLBAR_MODE_OFF);                   // 关闭滑动条
    
    // 标签对象
    label[i] = lv_label_create(but[i]); // 创建标签
    lv_obj_align(label[i], LV_ALIGN_CENTER, 0, 0);        // 对齐方式
    lv_label_set_text(label[i], obj_name[i].c_str());     // 标签文本
    if ((i % 6) < 3)
      lv_obj_set_style_text_color(label[i], MY_COLOR_BLACK, LV_STATE_DEFAULT);
    else
      lv_obj_set_style_text_color(label[i], MY_COLOR_WHITE, LV_STATE_DEFAULT);

    // 将对象邦定到组
    lv_group_add_obj(group_my, but[i]);
    // 添加按钮聚焦动画
    lv_obj_add_event_cb(but[i], buttonFocus_anim_event, LV_EVENT_FOCUSED, NULL);
    lv_obj_add_event_cb(but[i], buttonFocus_anim_event2, LV_EVENT_FOCUSED, NULL);
    // 按钮触发功能
    lv_obj_add_event_cb(but[i], clockSet_event, LV_EVENT_PRESSED, &num[i]);
  }

  lv_obj_t *but_exit = lv_button_create(page.p[page.index]);
  lv_obj_set_size(but_exit, 72, 25); // 设置大小
  // lv_obj_align(but1, LV_ALIGN_TOP_MID, 0, 5 * 46);                             // 设置对齐方式
  lv_obj_set_style_bg_color(but_exit, MY_COLOR_RED, LV_STATE_DEFAULT);          // 设置背景颜色
  lv_obj_add_style(but_exit, &style_shadow, LV_STATE_DEFAULT);                  // 设置阴影样式
  lv_obj_add_style(but_exit, &style_squareShape, LV_STATE_DEFAULT);             // 设置方型样式
  lv_obj_set_style_outline_width(but_exit, 2, LV_STATE_FOCUS_KEY);              // 聚焦框的宽度
  lv_obj_set_style_outline_pad(but_exit, 0, LV_STATE_FOCUS_KEY);                // 聚焦框的间隙
  lv_obj_set_style_outline_opa(but_exit, LV_OPA_100, LV_STATE_FOCUS_KEY);       // 聚焦框的不透明度
  lv_obj_set_style_outline_width(but_exit, 0, LV_STATE_DEFAULT);                // 失焦时的宽度
  lv_obj_set_style_outline_color(but_exit, MY_COLOR_BLACK, LV_STATE_FOCUS_KEY); // 聚焦框颜色
  lv_obj_set_scrollbar_mode(but_exit, LV_SCROLLBAR_MODE_OFF);                   // 关闭滑动条
  lv_obj_t *label_exit = lv_label_create(but_exit);                             // 创建标签
  lv_obj_align(label_exit, LV_ALIGN_CENTER, 0, 0);                              // 对齐方式
  lv_label_set_text(label_exit, "退出");                                        // 标签文本
  if ((optNum % 6) < 3)
    lv_obj_set_style_text_color(label_exit, MY_COLOR_BLACK, LV_STATE_DEFAULT);
  else
    lv_obj_set_style_text_color(label_exit, MY_COLOR_WHITE, LV_STATE_DEFAULT);

  lv_obj_add_event_cb(but_exit, backPage_mainSet_event, LV_EVENT_PRESSED, NULL); // 退出回调
  lv_obj_add_event_cb(but_exit, buttonFocus_anim_event, LV_EVENT_FOCUSED, NULL); // 添加聚焦动画
  lv_obj_add_event_cb(but_exit, buttonFocus_anim_event2, LV_EVENT_FOCUSED, NULL);

  lv_group_add_obj(group_my, but_exit);
}

//****** 空气质量界面
void display_air_event_msgbox(lv_event_t *e) // 当屏幕被聚焦时，弹窗弹窗
{
  uint8_t key = lv_indev_get_key(lv_indev_active());
  if (key == LV_KEY_RIGHT || key == LV_KEY_LEFT)
    my_msgbox_send(F("空气质量"), F("是否退出"), 0, F("退出\n返回\n"), backPage_mainSet);
}
void update_air_timer_cb(lv_timer_t *time) // 定时空气质量数据
{
  if (eep_disPage != page_air)
  {
    // bitWrite(backgroundTask, BGT_ACC_READ, 0); // 标记关闭
    return;
  }
  String airDescribe[] = {F("质量优"), F("轻污染"), F("中污染"), F("重污染")};
  lv_color_t color[] = {MY_COLOR_CYAN, MY_COLOR_YELLOW, MY_COLOR_MAGENTA, MY_COLOR_RED};
  uint8_t state = 0;
  lv_label_set_text_fmt(label_share[0], "VOC:%d", vocIndex);
  lv_label_set_text_fmt(label_share[1], "NOx:%d", noxIndex);

  if (vocIndex >= 400)
    state = 3;
  else if (vocIndex >= 250)
    state = 2;
  else if (vocIndex >= 150)
    state = 1;
  else
    state = 0;
  lv_obj_t *parent = lv_obj_get_parent(label_share[0]); // 获取父对象
  lv_obj_t *child = lv_obj_get_child(parent, 1);        // 获取父对象的第二大孩子
  lv_label_set_text(child, airDescribe[state].c_str());
  lv_obj_set_style_bg_color(parent, color[state], 0);

  if (noxIndex >= 300)
    state = 3;
  else if (noxIndex >= 150)
    state = 2;
  else if (noxIndex >= 20)
    state = 1;
  else
    state = 0;
  parent = lv_obj_get_parent(label_share[1]);
  child = lv_obj_get_child(parent, 1);
  lv_label_set_text(child, airDescribe[state].c_str());
  lv_obj_set_style_bg_color(parent, color[state], 0);

  String illustrate = "%d秒";
  if (sgp41_runTime <= 9)
    illustrate += F(",加热中");
  else if (noxIndex == 0)
    illustrate += F(",数据计算中");
  lv_coord_t scroll_offset = lv_obj_get_scroll_x(label_share[2]);
  lv_label_set_text_fmt(label_share[2], illustrate.c_str(), sgp41_runTime);
}
void display_air_init()
{
  eepSavePage(page_air);
  //LV_FONT_DECLARE(MiSans_Bold_16px);
  LV_FONT_DECLARE(MiSans_Bold_14px);

  uint8_t index = pageInit(KEY_MODE_RL, FIRST_EVENT_OFF);
  page.p[index] = lv_obj_create(NULL);
  lv_obj_set_size(page.p[index], TFT_HOR_RES, TFT_VER_RES);
  lv_obj_align(page.p[index], LV_ALIGN_CENTER, 0, 0);
  lv_obj_set_scrollbar_mode(page.p[index], LV_SCROLLBAR_MODE_OFF); //关闭滑动条
  lv_obj_set_style_pad_top(page.p[index], 3, LV_STATE_DEFAULT);
  lv_obj_set_style_pad_bottom(page.p[index], 3, LV_STATE_DEFAULT);

  // 将对象邦定到组
  lv_group_add_obj(group_my, page.p[index]);
  // 聚焦触发 弹出退出返回框
  lv_obj_add_event_cb(page.p[index], display_air_event_msgbox, LV_EVENT_KEY, NULL);

  uint8_t count = 0;
  lv_obj_t *obj[4];
  lv_obj_t *label;

  for (uint8_t i = 0; i < 4; i++)
  {
    // 基本对象
    obj[i] = lv_obj_create(page.p[index]);
    uint8_t step = 30;
    if (i == 1 || i == 2) step = 40;
    lv_obj_set_size(obj[i], 72, step);
    //lv_obj_align(obj[i], LV_ALIGN_TOP_MID, 0, i * step);
    if(i > 0) lv_obj_align_to(obj[i], obj[i - 1], LV_ALIGN_OUT_BOTTOM_MID, 0, 0);
    if(i == 0) lv_obj_set_style_bg_color(obj[i], MY_COLOR_GREEN, LV_STATE_DEFAULT);
    else lv_obj_set_style_bg_color(obj[i], MY_COLOR_CYAN, LV_STATE_DEFAULT);
    lv_obj_set_scrollbar_mode(obj[i], LV_SCROLLBAR_MODE_OFF); // 关闭滑动条
    lv_obj_add_style(obj[i], &style_shadow, LV_STATE_DEFAULT); // 添加阴影不透明度样式
    lv_obj_set_style_text_color(obj[i], MY_COLOR_BLACK, LV_STATE_DEFAULT);
  }

  String obj_name0 = F("空气质量");
  label = lv_label_create(obj[0]);
  lv_obj_align(label, LV_ALIGN_CENTER, 0, 0);
  lv_label_set_text(label, obj_name0.c_str());

  //  voc指数
  label_share[0] = lv_label_create(obj[1]);
  lv_obj_align(label_share[0], LV_ALIGN_TOP_LEFT, -12, -11);
  lv_obj_set_style_text_font(label_share[0], &MiSans_Bold_14px, 0);
  //  voc指数-质量描述
  lv_obj_t *label_0 = lv_label_create(obj[1]);
  lv_obj_align(label_0, LV_ALIGN_BOTTOM_LEFT, -12, +14);
  lv_obj_set_style_text_font(label_0, &MISans_16px, 0);

  //  nox指数
  label_share[1] = lv_label_create(obj[2]);
  lv_obj_align(label_share[1], LV_ALIGN_TOP_LEFT, -12, -11);
  lv_obj_set_style_text_font(label_share[1], &MiSans_Bold_14px, 0);
  //  nox指数-质量描述
  label_0 = lv_label_create(obj[2]);
  lv_obj_align(label_0, LV_ALIGN_BOTTOM_LEFT, -12, +14);
  lv_obj_set_style_text_font(label_0, &MISans_16px, 0);

  // 运行时间
  label_share[2] = lv_label_create(obj[3]);
  lv_obj_align(label_share[2], LV_ALIGN_LEFT_MID, -12, 0);
  lv_obj_set_width(label_share[2], 68);
  lv_label_set_long_mode(label_share[2], LV_LABEL_LONG_SCROLL); // 设置文本长字符模式
  lv_obj_set_style_anim_duration(label_share[2], 495, 0);
  lv_obj_set_style_text_font(label_share[2], &MISans_16px, 0);

  // 创建定时器并保存句柄
  lvTimer_share[0] = lv_timer_create(update_air_timer_cb, 1000, NULL); // 定时更新

  //int32_t num = lv_obj_get_child_count(page2);
  //LV_LOG_USER("page2对象数量:%u", num);
}

//****** 闹钟界面
void display_alarmClock_anim_cb(void *var, int32_t v) // 闹钟编辑界面弹出动画
{
  lv_obj_align((lv_obj_t *)var, LV_ALIGN_CENTER, v, 0); // 设置对齐方式
}
uint8_t getAlarmClockNumber() // 获取闹钟的数量
{
  File file = LittleFS.open(alarmClockRecord);
  if (!file)  return 0;

  uint8_t count = 0; //行计数

  while(file.available())
  {
    char c = file.read();
    if (c == '\n')
    {
      count++;
    }
  }
  file.close();
  return count;
}
void display_alarmClock_event_msgbox(lv_event_t *e) // 当屏幕被聚焦时，弹出退出弹窗
{
  uint8_t key = lv_indev_get_key(lv_indev_active());
  if (key == LV_KEY_PREV)
  {
    my_msgbox_send(F("闹钟"), F("是否退出"), 0, F("退出\n返回\n"), backPage_mainSet);
  }
}
void display_alarmClock_event0(lv_event_t *e)       // 按钮聚焦更改线条颜色
{
  lv_obj_t *obj = lv_event_get_target_obj(e);
  lv_obj_t *child = lv_obj_get_child(obj, 3);
  lv_obj_set_style_line_color(child, MY_COLOR_MAGENTA, 0);

  /*uint8_t key = lv_indev_get_key(lv_indev_active());
  lv_obj_t *focused_obj = lv_group_get_focused(group_my);
  lv_event_code_t code = lv_event_get_code(e);
  uint8_t focusPos = lv_obj_get_index(focused_obj);
  Serial.printf("focusPos:%d\n",focusPos);
  Serial.printf("key:%d\n",key);*/

  /*
  if (focusPos != 0 || focusPos != 5)
    lv_obj_set_scroll_snap_y(obj, LV_SCROLL_SNAP_CENTER); // 设置滚动结束时焦点的对齐方式
  else
    lv_obj_set_scroll_snap_y(obj, LV_SCROLL_SNAP_NONE); // 设置滚动结束时焦点的对齐方式
  */

  LV_UNUSED(obj);
}
void display_alarmClock_event1(lv_event_t *e)       // 按钮失焦更改线条颜色
{
  lv_obj_t *obj = lv_event_get_target_obj(e);
  lv_obj_t *child = lv_obj_get_child(obj, 3);
  lv_obj_set_style_line_color(child, MY_COLOR_CYAN, 0);
  LV_UNUSED(obj);
}
void display_alarmClock_event3(lv_event_t *e)       // 切换至编辑界面
{
  buzzerSen(30);
  // lv_obj_t *obj = lv_event_get_target_obj(e);
  // lv_obj_set_state(obj, LV_STATE_PRESSED, false); // 取消按下状态
  display_alarmClock_edit_init();
}
void display_alarmClock_init()
{
  LV_FONT_DECLARE(MiSans_Bold_14px);

  eepSavePage(page_alarmClock, 1); // 保存现在的界面

  uint8_t index = pageInit(KEY_MODE_PN, FIRST_EVENT_OFF);
  page.p[index] = lv_obj_create(NULL);
  lv_obj_set_scrollbar_mode(page.p[index], LV_SCROLLBAR_MODE_OFF);       // 关闭滑动条
  lv_obj_add_style(page.p[index], &style_shadow, LV_STATE_DEFAULT);      // 添加阴影不透明度样式
  lv_obj_add_style(page.p[index], &style_squareShape, LV_STATE_DEFAULT); // 添加方形样式
  lv_obj_set_style_pad_top(page.p[index], 3, LV_STATE_DEFAULT);
  lv_obj_set_style_pad_bottom(page.p[index], 3, LV_STATE_DEFAULT);

  lv_obj_set_scroll_snap_y(page.p[index], LV_SCROLL_SNAP_CENTER); // 设置滚动结束时焦点的对齐方式

  uint8_t acNum = getAlarmClockNumber();
  if (acNum == 0) // 无文件退出
  {
    my_msgbox_send(F("闹钟"), F("记录丢失"), 0, F("退出\n返回\n"), backPage_mainSet);
    return;
  }

  uint16_t sw_state = 0; // 开关状态位
  String text_time[acNum]; // 时间
  String text_week[acNum]; // 星期
  File file = LittleFS.open(alarmClockRecord);
  for (uint8_t i = 0; i < acNum; i++)
  {
    // 提取开关状态位
    char c = file.read();
    if (c == '1') bitWrite(sw_state, i, 1);
    // 提取星期
    for (uint8_t j = 0; j < 7; j++)
    {
      char c = file.read();
      if(c > '0') text_week[i] += c;
    }
    // 提取小时
    text_time[i] += char(file.read());
    text_time[i] += char(file.read());
    text_time[i] += ":";
    // 提取分钟
    text_time[i] += char(file.read());
    text_time[i] += char(file.read());
    file.read(); //跳过/r 0x0d
    file.read(); //跳过/n 0x0a
  }
  file.close();

  // 创建线条
  static lv_point_precise_t line_points[] = {{0, 0}, {54, 0}};

  /*Create style*/
  /*static lv_style_t style_line;
  lv_style_init(&style_line);
  lv_style_set_line_width(&style_line, 2);
  lv_style_set_line_color(&style_line, MY_COLOR_CYAN);
  //lv_style_set_line_rounded(&style_line, true);*/

  lv_obj_t *but[acNum];
  lv_obj_t *label_time[acNum];
  lv_obj_t *label_week[acNum];
  lv_obj_t *sw[acNum];
  for (uint8_t i = 0; i < acNum; i++)
  {
    // 按钮对象-即外框
    but[i] = lv_button_create(page.p[index]);
    lv_obj_set_size(but[i], 72, 40);                   // 设置大小
    lv_obj_align(but[i], LV_ALIGN_TOP_MID, 0, i * 44); // 设置对齐方式
    lv_obj_set_style_bg_color(but[i], MY_COLOR_WHITE, LV_STATE_DEFAULT);    // 设置背景颜色
    //lv_obj_set_style_bg_color(but[i], MY_COLOR_YELLOW, LV_STATE_FOCUS_KEY); // 聚焦时设置背景颜色
    lv_obj_set_style_bg_opa(but[i], LV_OPA_100, LV_STATE_DEFAULT); // 设置背景不透明度
    lv_obj_add_style(but[i], &style_shadow, LV_STATE_DEFAULT);     // 设置阴影样式
    lv_obj_set_style_pad_all(but[i], 0, 0);                        // 设置边界
    lv_obj_set_style_border_width(but[i], 0, 0);                   // 边框宽度
    lv_obj_set_style_radius(but[i], 6, 0);                         // 设置圆角

    lv_obj_set_style_border_width(but[i], 3, 0);              // 设置边框宽度
    lv_obj_set_style_border_color(but[i], MY_COLOR_BLACK, 0); // 设置边框颜色

    lv_obj_set_style_outline_width(but[i], 2, LV_STATE_FOCUS_KEY);                // 聚焦框的宽度
    lv_obj_set_style_outline_pad(but[i], 0, LV_STATE_FOCUS_KEY);                  // 聚焦框的间隙
    lv_obj_set_style_outline_opa(but[i], LV_OPA_100, LV_STATE_FOCUS_KEY);         // 聚焦框的不透明度
    lv_obj_set_style_outline_width(but[i], 0, LV_STATE_DEFAULT);                  // 失焦时的宽度
    lv_obj_set_style_outline_color(but[i], MY_COLOR_MAGENTA, LV_STATE_FOCUS_KEY); // 聚焦框颜色
    lv_obj_set_scrollbar_mode(but[i], LV_SCROLLBAR_MODE_OFF);                     // 关闭滑动条

    // 时间标签对象
    label_time[i] = lv_label_create(but[i]);                // 创建标签
    lv_obj_align(label_time[i], LV_ALIGN_LEFT_MID, 2, -9);  // 对齐方式
    lv_label_set_text(label_time[i], text_time[i].c_str()); // 标签文本
    lv_obj_set_style_text_font(label_time[i], &MiSans_Bold_14px, 0);
    lv_obj_set_style_text_color(label_time[i], MY_COLOR_BLACK, 0); // 字体颜色

    // 星期标签对象
    label_week[i] = lv_label_create(but[i]);                // 创建标签
    lv_obj_align(label_week[i], LV_ALIGN_BOTTOM_MID, 0, 3); // 对齐方式
    lv_label_set_text(label_week[i], text_week[i].c_str()); // 标签文本
    lv_obj_set_style_text_font(label_week[i], &MISans_16px, 0);
    lv_obj_set_style_text_color(label_week[i], MY_COLOR_BLACK, 0); // 字体颜色

    // 创建开关
    sw[i] = lv_switch_create(but[i]);
    lv_obj_set_size(sw[i], 20, 11);
    lv_obj_align(sw[i], LV_ALIGN_TOP_RIGHT, -2, 2);
    lv_obj_set_style_bg_color(sw[i], MY_COLOR_RED, LV_PART_MAIN);                           // 开关 关闭的背景颜色
    lv_obj_set_style_bg_color(sw[i], MY_COLOR_GREEN, LV_PART_INDICATOR | LV_STATE_CHECKED); // 开关 打开的背景颜色
    lv_obj_set_style_bg_color(sw[i], MY_COLOR_WHITE, LV_PART_KNOB);                         // 手柄颜色
    if (bitRead(sw_state, i) == 1)
      lv_obj_add_state(sw[i], LV_STATE_CHECKED); // 添加状态
    //else
      //lv_obj_add_state(sw[i], LV_STATE_DEFAULT); // 添加状态

    // 创建线条
    lv_obj_t *line1;
    line1 = lv_line_create(but[i]);
    lv_line_set_points(line1, line_points, 2);
    lv_obj_center(line1);
    lv_obj_align(line1, LV_ALIGN_CENTER, 0, -1);
    lv_obj_set_style_line_width(line1, 2, 0);
    lv_obj_set_style_line_color(line1, MY_COLOR_CYAN, 0);
    // 将对象邦定到组
    lv_group_add_obj(group_my, but[i]);
    // 添加按钮聚焦动画 
    lv_obj_add_event_cb(but[i], buttonFocus_anim_event, LV_EVENT_FOCUSED, NULL);
    lv_obj_add_event_cb(but[i], display_alarmClock_event0, LV_EVENT_FOCUSED, NULL);
    lv_obj_add_event_cb(but[i], display_alarmClock_event1, LV_EVENT_DEFOCUSED, NULL);
    // 按钮触发功能
    lv_obj_add_event_cb(but[i], display_alarmClock_event3, LV_EVENT_PRESSED, NULL); // 切换编辑状态
  }

  // 将对象邦定到组
  lv_group_add_obj(group_my, page.p[index]);
  // 聚焦触发 弹出退出返回框
  lv_obj_add_event_cb(page.p[index], display_alarmClock_event_msgbox, LV_EVENT_FOCUSED, NULL);
}

//****** 闹钟编辑界面
void alarmClock_edit_exit1(lv_anim_t *a)       // 退出
{
  lv_obj_delete(box_share[0]);         // 删除对象
  box_share[0] = NULL;                 // 对象地址清空
  lv_indev_set_group(indev, group_my); // 将组邦定到按键

  //****** 更改记录文件
  // 拼装记录
  bool change = 0;
  String record,record_old;
  String hour = String(shareNum[8]);
  String minute = String(shareNum[9]);
  String week;
  if (shareNum[8] <= 9) hour = "0" + hour;
  if (shareNum[9] <= 9) minute = "0" + minute;
  for (uint8_t i = 0; i < 8; i++)
  {
    // Serial.print("shareNum[" + String(i) + "]:");
    // Serial.println(shareNum[i]);
    String s = String(shareNum[i]);
    record += s;
    //拼装星期
    if (i > 0 && shareNum[i] > 0) week += s;
  }
  record += hour + minute;

  // 打开记录文件
  File file = LittleFS.open(alarmClockRecord, "r+");
  file.seek(focusPos_old[focusPos_old_index] * 14); //偏移至正确位置
  //获取旧内容
  for (uint8_t i = 0; i < 12; i++) record_old += char(file.read());
  //字符串不同就更改文件
  if (strcmp(record.c_str(), record_old.c_str()) != 0)
  {
    //Serial.println("更改文件");
    file.seek(focusPos_old[focusPos_old_index] * 14);
    file.print(record);
    change = 1;
  }
  file.close();

  // 获取闹钟主界面刚才被聚焦的对象
  lv_obj_t *child = lv_obj_get_child(page.p[page.index], focusPos_old[focusPos_old_index]);
  //Serial.printf("focusPos_old:%d\n", focusPos_old[focusPos_old_index]);
  // lv_obj_set_state(child, LV_STATE_PRESSED, false); // 取消按下状态
  // lv_group_focus_obj(child);                        // 聚焦当前按钮

  if (change)
  {
    // 更新内容
    lv_obj_t *label_time = lv_obj_get_child(child, 0); // 时间
    lv_obj_t *label_week = lv_obj_get_child(child, 1); // 星期
    lv_obj_t *sw = lv_obj_get_child(child, 2);         // 开关
    String time = hour + ":" + minute;
    lv_label_set_text(label_time, time.c_str()); // 标签文本
    lv_label_set_text(label_week, week.c_str()); // 标签文本
    if (shareNum[0] == 1)
      lv_obj_set_state(sw, LV_STATE_CHECKED, true); // 切换为打开状态
    else
      lv_obj_set_state(sw, LV_STATE_CHECKED, false); // 切换为关闭状态

    updatealarmClockDifference();
  }
  LV_UNUSED(child);

  // 回到刚才的焦点
  focusPosOld_return();
  
  //Serial.printf("record_old:%s\n", record_old);
 // Serial.printf("record:%s\n", record);
}
void alarmClock_edit_exit0(lv_event_t *e)      // 弹窗退出返回 至主设置界面
{
  // 检查是否在退出中 防止重复触发
  lv_anim_t *b = lv_anim_get(box_share[0], display_alarmClock_anim_cb);
  if (b != NULL) return;

  lv_anim_t a;
  lv_anim_init(&a);                                    // 动画初始化
  lv_anim_set_var(&a, box_share[0]);                   // 设置需要动画的对象
  lv_anim_set_values(&a, 0, 72);                       // 设置动画的开始值和结束值
  lv_anim_set_duration(&a, MSGBOX_ANIM_TIME);          // 设置动画的持续时间
  lv_anim_set_exec_cb(&a, display_alarmClock_anim_cb); // 设置需要变化的值
  lv_anim_set_path_cb(&a, lv_anim_path_overshoot);     // 设置变化特效
  lv_anim_set_completed_cb(&a, alarmClock_edit_exit1); // 设置动画完成时的函数调用
  lv_anim_start(&a);
}
void alarmClock_edit_sw_event(lv_event_t *e)   // 开启/关闭切换
{
  //检查动画是否播放中，播放中就退出
  lv_obj_t *obj = lv_event_get_target_obj(e);
  bool run = addAnimation_event(obj, button_width_shrink_anim_init); // 添加动画不重叠
  if(run == 1) return;

  shareNum[0] = !shareNum[0];
  String str = F("已开启");
  if (shareNum[0] == 0) str = F("已关闭");
  lv_label_set_text(obj, str.c_str()); // 标签文本
}
void alarmClock_edit_seek_event(lv_event_t *e) // 星期切换
{
  //检查动画是否播放中，播放中就退出
  lv_obj_t *obj = lv_event_get_target_obj(e);
  bool run = addAnimation_event(obj, button_width_shrink_anim_init); // 添加动画不重叠
  if(run == 1) return;

  uint8_t *data = (uint8_t *)lv_event_get_user_data(e);
  uint8_t i = data[0];

  if (shareNum[i] == 0) shareNum[i] = i;
  else                  shareNum[i] = 0;

  lv_label_set_text_fmt(obj, "%d", i); // 标签文本
  if (shareNum[i] != 0)
    lv_obj_set_style_text_color(obj, MY_COLOR_RED, 0); // 字体颜色
  else
    lv_obj_set_style_text_color(obj, MY_COLOR_BLACK, 0); // 字体颜色
}
void alarmClock_edit_time_event(lv_event_t *e) // 小时和分钟切换编辑模式和编辑
{
  lv_obj_t *obj = lv_event_get_target_obj(e);
  uint8_t *data = (uint8_t *)lv_event_get_user_data(e);
  uint8_t i = data[0];

  uint8_t key = lv_indev_get_key(lv_indev_active());
  if (key == LV_KEY_ENTER)
  {
    lv_obj_t *obj = lv_event_get_target_obj(e);
    bool run = addAnimation_event(obj, button_width_shrink_anim_init); // 添加动画不重叠
    if(run == 1) return;

    if (page.keyMode == KEY_MODE_PN)
    {
      lv_obj_set_style_text_color(obj, MY_COLOR_RED, 0);
      page.keyMode = KEY_MODE_RL;
    }
    else if (page.keyMode == KEY_MODE_RL)
    {
      lv_obj_set_style_text_color(obj, MY_COLOR_BLACK, 0);
      page.keyMode = KEY_MODE_PN;
    }
  }
  else if(page.keyMode == KEY_MODE_RL) //编辑模式进行加减操作
  {
    lv_obj_t *obj = lv_event_get_target_obj(e);
    addAnimation_event(obj, button_width_shrink_anim_init); // 添加动画不重叠
    if (key == LV_KEY_LEFT) // 减
    {
      if (*sm0.num_u8[i] == sm0.min[i])
        *sm0.num_u8[i] = sm0.max[i];
      else
        *sm0.num_u8[i] -= sm0.step[i];
    }
    else if (key == LV_KEY_RIGHT) // 加
    {
      if (*sm0.num_u8[i] == sm0.max[i])
        *sm0.num_u8[i] = sm0.min[i];
      else
        *sm0.num_u8[i] += sm0.step[i];
    }
    String str = String(*sm0.num_u8[i]);
    if (*sm0.num_u8[i] <= 9)  str = "0" + str;
    lv_label_set_text_fmt(obj, "%s", str); // 标签文本
  }

}
void display_alarmClock_edit_init()
{
  LV_FONT_DECLARE(MiSans_Bold_14px);
  LV_FONT_DECLARE(MiSans_Medium_16px);

  //****** 可调数值初始化
  uint8_t j = 0;
  sm0.num_u8[j++] = &shareNum[8];
  sm0.num_u8[j++] = &shareNum[9];
  j = 0;
  sm0.step[j++] = 1; // 加减的步进值
  sm0.step[j++] = 1; // 加减的步进值
  j = 0;
  sm0.min[j++] = 0;  // 最小值
  sm0.min[j++] = 0;  // 最小值
  j = 0;
  sm0.max[j++] = 23; // 最大值
  sm0.max[j++] = 59; // 最大值

  eepSavePage(page_alarmClockEdit, 0); // 保存现在的界面
  focusPosOld_save();                  // 保存上一个界面的焦点

  // 启用弹窗组
  lv_indev_set_group(indev, group_mbox1);
  page.keyMode == KEY_MODE_PN;

  // 创建容器盒子
  box_share[0] = lv_obj_create(lv_layer_top());      // lv_screen_active() lv_layer_top() lv_layer_sys()
  lv_obj_set_scrollbar_mode(box_share[0], LV_SCROLLBAR_MODE_OFF);
  lv_obj_add_style(box_share[0], &style_shadow, LV_STATE_DEFAULT);      // 添加阴影不透明度样式
  lv_obj_add_style(box_share[0], &style_squareShape, LV_STATE_DEFAULT); // 添加方向样式
  lv_obj_set_style_bg_opa(box_share[0], LV_OPA_0, 0);

  // 创建实际盒子 即 外边框
  lv_obj_t *box = lv_obj_create(box_share[0]);
  lv_obj_set_scrollbar_mode(box, LV_SCROLLBAR_MODE_OFF);
  lv_obj_set_size(box, 72, 120);
  lv_obj_align(box, LV_ALIGN_CENTER, 0, 0); // 设置对齐方式
  // 删除滚动条样式以获得干净的开始
  // lv_obj_remove_style(box, NULL, LV_PART_SCROLLBAR | LV_STATE_ANY);
  lv_obj_add_style(box, &style_shadow, LV_STATE_DEFAULT); // 添加阴影不透明度样式
  lv_obj_set_style_pad_top(box, 6, LV_STATE_DEFAULT);
  lv_obj_set_style_pad_bottom(box, 6, LV_STATE_DEFAULT);
  lv_obj_set_style_radius(box, 12, 0);                  // 设置圆角
  lv_obj_set_style_border_width(box, 2, 0);             // 设置边框宽度
  lv_obj_set_style_border_color(box, MY_COLOR_CYAN, 0); // 设置边框颜色
  // lv_obj_set_style_bg_opa(box, LV_OPA_0, 0);

  // 创建内边框
  lv_obj_t *innerBorder = lv_obj_create(box_share[0]);
  lv_obj_set_size(innerBorder, 68, 116);
  lv_obj_align(innerBorder, LV_ALIGN_CENTER, 0, 0);             // 设置对齐方式
  lv_obj_add_style(innerBorder, &style_shadow, LV_STATE_DEFAULT); // 添加阴影不透明度样式
  lv_obj_set_style_pad_top(innerBorder, 0, LV_STATE_DEFAULT);
  lv_obj_set_style_pad_bottom(innerBorder, 0, LV_STATE_DEFAULT);
  lv_obj_set_style_radius(innerBorder, 10, 0);                     // 设置圆角
  lv_obj_set_style_border_width(innerBorder, 1, 0);                // 设置边框宽度
  lv_obj_set_style_border_color(innerBorder, MY_COLOR_MAGENTA, 0); // 设置边框颜色
  lv_obj_set_style_bg_opa(innerBorder, LV_OPA_0, 0);

  // 打开记录文件，偏移至正确位置
  File file = LittleFS.open(alarmClockRecord);
  file.seek(focusPos_old[focusPos_old_index] * 14);
  //提取开关状态
  char c = file.read();
  if (c == '1') shareNum[0] = 1;
  else shareNum[0] = 0;
  // 提取星期
  for (uint8_t i = 1; i <= 7; i++)
  {
    char c = file.read();
    shareNum[i] = c - 48;
    //Serial.printf("shareNum[i]:%d\n", shareNum[i]);
  }
  // 提取时间
  String hour, minute;
  hour += char(file.read()); // 提取小时
  hour += char(file.read());
  minute += char(file.read()); // 提取分钟
  minute += char(file.read());
  shareNum[8] = atoi(hour.c_str());
  shareNum[9] = atoi(minute.c_str());
  file.close();
  lv_obj_t *label_sw;
  lv_obj_t *label_week[7];
  lv_obj_t *label_hour;
  lv_obj_t *label_minute;
  lv_obj_t *label_exit;
  // 开启/关闭
  label_sw = lv_label_create(box);      // 创建标签
  lv_obj_align(label_sw, LV_ALIGN_CENTER, 0, -46); // 对齐方式
  String str = F("已开启");
  if (shareNum[0] == 0) str = F("已关闭");
  lv_label_set_text(label_sw, str.c_str()); // 标签文本
  lv_obj_set_style_text_color(label_sw, MY_COLOR_BLACK, 0);  // 字体颜色
  lv_obj_add_flag(label_sw, LV_OBJ_FLAG_SCROLLABLE);         // 使对象可滚动
  lv_obj_add_flag(label_sw, LV_OBJ_FLAG_SCROLL_ON_FOCUS);    // 自动滚动对象以使其在聚焦时可见
  // 星期
  int8_t x[7] = {-24, -8, +8, +24, -18, 0, +18};
  int8_t y[2] = {+35, +50};
  for (uint8_t i = 1; i <= 7; i++)
  {
    label_week[i - 1] = lv_label_create(box); // 创建标签
    if (i <= 4)
      lv_obj_align(label_week[i - 1], LV_ALIGN_CENTER, x[i - 1], y[0]);
    else
      lv_obj_align(label_week[i - 1], LV_ALIGN_CENTER, x[i - 1], y[1]);
    lv_label_set_text_fmt(label_week[i - 1], "%d", i); // 标签文本
    lv_obj_set_style_text_font(label_week[i - 1], &MiSans_Bold_14px, 0);
    if (shareNum[i] != 0)
      lv_obj_set_style_text_color(label_week[i - 1], MY_COLOR_RED, 0); // 字体颜色
    else
      lv_obj_set_style_text_color(label_week[i - 1], MY_COLOR_BLACK, 0); // 字体颜色

    // 添加按钮按下回调
    lv_obj_add_event_cb(label_week[i - 1], alarmClock_edit_seek_event, LV_EVENT_PRESSED, &num[i]);
  }

  // 小时
  label_hour = lv_label_create(box);          // 创建标签
  lv_obj_set_width(label_hour, 26);
  lv_obj_align(label_hour, LV_ALIGN_CENTER, -16, -4);  // 对齐方式
  lv_label_set_text_fmt(label_hour, "%s", hour); // 标签文本
  lv_obj_set_style_text_font(label_hour, &MiSans_Medium_16px, 0);
  // 添加按钮按下回调
  lv_obj_add_event_cb(label_hour, alarmClock_edit_time_event, LV_EVENT_KEY, &num[0]);
  
  // 分钟
  label_minute = lv_label_create(box); // 创建标签
  lv_obj_set_width(label_minute, 26);
  lv_obj_align(label_minute, LV_ALIGN_CENTER, +16, -4); // 对齐方式
  lv_label_set_text_fmt(label_minute, "%s", minute);    // 标签文本
  lv_obj_set_style_text_font(label_minute, &MiSans_Medium_16px, 0);
  // 添加按钮按下回调
  lv_obj_add_event_cb(label_minute, alarmClock_edit_time_event, LV_EVENT_KEY, &num[1]);
  
  // 时间
  lv_obj_t *label = lv_label_create(box);                // 创建标签
  lv_obj_align(label, LV_ALIGN_CENTER, 0, -23); // 对齐方式
  lv_label_set_text(label, "时间");             // 标签文本

  // 星期
  label = lv_label_create(box);                // 创建标签
  lv_obj_align(label, LV_ALIGN_CENTER, 0, +18); // 对齐方式
  lv_label_set_text(label, "星期");             // 标签文本

  // 冒号
  label = lv_label_create(box);                // 创建标签
  lv_obj_align(label, LV_ALIGN_CENTER, 0, -4); // 对齐方式
  lv_label_set_text(label, ":");             // 标签文本
  lv_obj_set_style_text_font(label, &MiSans_Medium_16px, 0);

  // 退出
  label_exit = lv_label_create(box);                 // 创建标签
  lv_obj_align(label_exit, LV_ALIGN_CENTER, 0, 72);  // 对齐方式
  lv_label_set_text(label_exit, String("退出").c_str());             // 标签文本
  lv_obj_add_flag(label_exit, LV_OBJ_FLAG_SCROLLABLE);      // 使对象可滚动
  lv_obj_add_flag(label_exit, LV_OBJ_FLAG_CLICKABLE);       // 使对象可被输入设备点击
  lv_obj_add_flag(label_exit, LV_OBJ_FLAG_SCROLL_ON_FOCUS); // 自动滚动对象以使其在聚焦时可见

  // 创建线条
  static lv_point_precise_t line_points0[] = {{0, 0}, {55, 0}};
  // 创建线条
  lv_obj_t *line;
  line = lv_line_create(box);
  lv_line_set_points(line, line_points0, 2);
  lv_obj_center(line);
  lv_obj_align(line, LV_ALIGN_CENTER, 0, -35);
  lv_obj_set_style_line_width(line, 2, 0);
  lv_obj_set_style_line_color(line, MY_COLOR_MAGENTA, 0);
  line = lv_line_create(box);
  lv_line_set_points(line, line_points0, 2);
  lv_obj_center(line);
  lv_obj_align(line, LV_ALIGN_CENTER, 0, +5);
  lv_obj_set_style_line_width(line, 2, 0);
  lv_obj_set_style_line_color(line, MY_COLOR_MAGENTA, 0);
  line = lv_line_create(box);
  lv_line_set_points(line, line_points0, 2);
  lv_obj_center(line);
  lv_obj_align(line, LV_ALIGN_CENTER, 0, +60);
  lv_obj_set_style_line_width(line, 2, 0);
  lv_obj_set_style_line_color(line, MY_COLOR_MAGENTA, 0);

  lv_obj_t *zj[] = {
      label_sw,
      label_hour,
      label_minute,
      label_week[0],
      label_week[1],
      label_week[2],
      label_week[3],
      label_week[4],
      label_week[5],
      label_week[6],
      label_exit,
  };
  for (uint8_t i = 0; i < 11; i++)
  {
    /*lv_obj_set_style_outline_width(zj[i], 2, LV_STATE_FOCUS_KEY);                // 聚焦框的宽度
    lv_obj_set_style_outline_pad(zj[i], 0, LV_STATE_FOCUS_KEY);                  // 聚焦框的间隙
    lv_obj_set_style_outline_opa(zj[i], LV_OPA_100, LV_STATE_FOCUS_KEY);         // 聚焦框的不透明度
    lv_obj_set_style_outline_width(zj[i], 0, LV_STATE_DEFAULT);                  // 失焦时的宽度
    lv_obj_set_style_outline_color(zj[i], MY_COLOR_MAGENTA, LV_STATE_FOCUS_KEY); // 聚焦框颜色*/
    lv_obj_set_style_outline_width(zj[i], 0, LV_STATE_DEFAULT);   // 失焦时的宽度
    lv_obj_set_style_outline_width(zj[i], 0, LV_STATE_FOCUS_KEY); // 聚焦时的宽度
    lv_obj_set_style_bg_opa(zj[i], LV_OPA_100, LV_STATE_FOCUS_KEY);
    lv_obj_set_style_bg_color(zj[i], MY_COLOR_CYAN, LV_STATE_FOCUS_KEY);
    lv_obj_set_style_radius(zj[i], 4, LV_STATE_FOCUS_KEY);
    lv_obj_set_style_pad_top(zj[i], -5, LV_STATE_DEFAULT);
    lv_obj_set_style_pad_bottom(zj[i], -5, LV_STATE_DEFAULT);
    lv_obj_set_style_pad_right(zj[i], 3, LV_STATE_DEFAULT);
    lv_obj_set_style_pad_left(zj[i], 3, LV_STATE_DEFAULT);
    // 设置文本长字符模式
    lv_label_set_long_mode(zj[i], LV_LABEL_LONG_SCROLL); 
    // 将对象邦定到组
    lv_group_add_obj(group_mbox1, zj[i]);
    // 添加按钮聚焦动画
    lv_obj_add_event_cb(zj[i], buttonFocus_anim_event, LV_EVENT_FOCUSED, NULL);
  }

  // 添加按钮按下回调
  lv_obj_add_event_cb(label_exit, alarmClock_edit_exit0, LV_EVENT_PRESSED, NULL);
  // 添加按钮按下回调
  lv_obj_add_event_cb(label_sw, alarmClock_edit_sw_event, LV_EVENT_PRESSED, NULL);

  // 添加进入动画
  lv_anim_t a;
  lv_anim_init(&a);                                    // 动画初始化
  lv_anim_set_var(&a, box_share[0]);                   // 设置需要动画的对象
  lv_anim_set_values(&a, 36, 0);                       // 设置动画的开始值和结束值
  lv_anim_set_duration(&a, MSGBOX_ANIM_TIME);          // 设置动画的持续时间
  lv_anim_set_exec_cb(&a, display_alarmClock_anim_cb); // 设置需要变化的值
  lv_anim_set_path_cb(&a, lv_anim_path_bounce);        // 设置变化特效
  // lv_anim_set_completed_cb(&a, NULL); // 设置动画完成时的函数调用
  lv_anim_start(&a);
}

//****** 蜂鸣器设置界面
void display_buzzerSet_event0(lv_event_t *e) // 当背景对象被聚焦时，弹出弹窗或定位到第1个对象
{
  if (page.firstEvent) // 首次进入该事件时 手动定位到第一个焦点
  {
    // Serial.println("下一个焦点");
    page.firstEvent = 0;
    lv_obj_t *child = lv_obj_get_child(page.p[page.index], 0);
    lv_group_focus_obj(child);
    LV_UNUSED(child);
  }
}
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
