jie326513988/ESP32C3-JDI-LCD-LVGL/(commit log)

2024-05-07 上传项目文件
2024-05-07 Create JDI 0.96(0.85)低功耗屏 LPM009M360A.pdf
2024-05-12 更新像素抖动算法
    误差扩散
2025-05-25 V15.1
    提交全部源码
2025-05-25 V15.1
    图片重命名
2025-06-07 更新库文件
